ahamal/magic-table/software/esper/firmware/README.md

# Esper firmware (ESP32-S3)

[`firmware.ino`](firmware.ino) runs Esper on the Freenove ESP32-S3-WROOM CAM: Wi-Fi API, both wheels, the flipper servo straight from the ESP32's PWM, the OLED face (bitmaps and animations), the camera and the control page at `http://esper.local/`. Endpoints and how to get pictures: [`../README.md`](../README.md#api). Pins: [`hardware/esper`](../../../hardware/esper/README.md#pins-freenove-esp32-s3-wroom-cam).

## Build

Copy `secrets.example.h` to `secrets.h` (git-ignored) and fill in the Wi-Fi name and password. The ESP32 needs a 2.4 GHz network.

```bash
arduino-cli lib install AccelStepper "Adafruit SSD1306" "Adafruit GFX Library"
arduino-cli compile --fqbn esp32:esp32:esp32s3:PSRAM=opi,FlashSize=8M,PartitionScheme=default_8MB software/esper/firmware
arduino-cli upload --fqbn esp32:esp32:esp32s3:PSRAM=opi,FlashSize=8M,PartitionScheme=default_8MB -p /dev/cu.usbmodem5C930529801 software/esper/firmware
```

Use the USB-C port marked for serial (the CH343, `/dev/cu.usbmodem…`). The camera and PSRAM need `PSRAM=opi`; without it the camera fails to start.

Serial (115200) prints the IP and `READY oled=… cam=…` once it's up.

## How it's put together

- **Cores:** `loop()` on core 1 only runs the steppers. The API server, I2C and OLED run in `netTask` on core 0; the video stream is a second server (port 81) with its own task.
- **Camera:** tries hardware JPEG first (OV2640/OV3660); the bundled GC0308 can't, so it falls back to RGB565 at 640×480 and encodes with `frame2jpg`.
- **Camera sleeps between pictures.** On this board a running camera wrecks Wi-Fi (pings 100–300 ms, multi-second stalls even at 10 MHz). The camera clock (LEDC timer 3) is paused unless a capture or stream is in progress, and a snapshot is sent after the camera goes back to sleep. Measured: idle ping ~11 ms, snapshot ~0.9 s, stream ~2 fps.
- **Battery hardening:** on the power bank the MG996R's current sagged the 5V and tripped the brownout reset. The firmware turns that reset off with `esp_brownout_disable()` (writing 0 to `RTC_CNTL_BROWN_OUT_REG`, the usual ESP32 trick, boot-loops the S3) and lowers Wi-Fi transmit power to 8.5 dBm. `/status` reports `reset_reason` and `boots` (restarts since power-up), so a returning problem shows up at once.
- **IPv6 is on** only so `esper.local` resolves at once on a Mac; without it every lookup waits 5 s for an IPv6 answer.
- **Flipper memory:** the angle is saved with `Preferences` (NVS key `esper/servo`) once the flipper has settled for 2 s with the wheels idle, and only when it changed. At boot `restoreServo()` starts the pulse at the saved angle, then sweeps to `SERVO_PARK` (20°) at 40°/s; `updateServo()` also runs in the Wi-Fi connect loop, so the sweep is done by the time Esper is online. This is the only flash write while running; it waits for the motors to be still because the brownout reset is off.
- **Servo:** LEDC channel 0 at 50 Hz, 14-bit, attached after the camera so it takes timer 0 and stays off the camera's timer 3.
- **Orientation:** the camera is mounted upside down, so it starts with `vflip` and `hmirror` on (180°). The GC0308 driver ignores `vflip`, so for raw sensors both flips are done in software on the frame before encoding (a 180° turn is just reversing the pixel buffer); JPEG sensors flip in hardware. The OLED uses rotation 0.
- **Screen frames** live in PSRAM: two 64-frame buffers, swapped when an upload completes, so a half-received upload never shows. `updateOled()` in `netTask` advances one frame every `1000 / fps` ms and wraps to the first, counting loops; after `X-Repeat` loops (if not 0) it stops on the last frame and sets `done`; a single frame is drawn once, and the status screen redraws every 500 ms. Sending a frame to the OLED over I2C takes ~25 ms, which is why 30 fps is the cap. The frame rate and repeat count are headers (`X-FPS`, `X-Repeat`) because `WebServer` doesn't parse query args when it hands over a raw body.

The earlier Arduino Nano firmware (USB serial protocol) was removed; it's in git history if ever needed. The classic-DevKit bench test is in [`../tests/web_i2c/`](../tests/web_i2c/).
