ahamal/magic-table/software/esper/server/README.md

# Esper server (retired)

Esper used to be a Raspberry Pi 3 running a Python web server that talked to an Arduino over USB serial. Esper now runs on an ESP32, which serves the API itself over Wi-Fi — see [`../firmware`](../firmware) and the API spec in [`../README.md`](../README.md).

Nothing was written here before the switch. The Pi 3 is a spare.
