ahamal/magic-table/docs/log.md

# Build log

What happened, when, and what we learned. Newest at the bottom. Times are ET and approximate unless they come from a commit. Settled choices also go in [`decisions.md`](decisions.md).

## Oct 26 (day 1)

- **12:00** Project structure and design docs (commit `2db1535`).

## Oct 28 (day 3)

- **04:12** Esper switches from Pi 3B + Nano to an **ESP32**. First wheels added (commit `dfce644`).
- **06:01** Printed plywood corner joints for the Esper chassis (commit `ed77900`).
- **Wheels:** the 28BYJ-48 bore was too tight at +0.2 and +0.4 mm. The fit test picked **+0.5 mm** (5.5 mm round, 3.5 mm across the flats).
- **ESP32 bring-up, three rounds, all passed** on a classic ESP32 DevKit:
  1. I2C: VL6180X (0x29), SSD1306 OLED (0x3C), PCA9685 (0x40).
  2. Web server at `esper.local`, about 25 ms per request with Wi-Fi power saving off.
  3. Both 28BYJ-48 steppers over Wi-Fi.
- **The OLED is mounted upside down,** so the firmware sets rotation 2.
- **A 3.3V-to-GND short in the I2C/hub wiring** caused brownouts and failed uploads, and damaged one board. That board still runs, but browns out with Wi-Fi on. Lessons:
  - Meter 3.3V ↔ GND before connecting a board.
  - Upload with only USB connected.
  - `arduino-cli upload` doesn't compile, so compile first.
  - A failed upload erases the flash (`invalid header: 0xffffffff`).
- **11:14** ESP32 bring-up test committed (commit `97774d6`).
- **11:15** Nano firmware removed (commit `42c9ae4`).
- **Speed:** the 28BYJ-48 tops out at about 3.7 cm/s with a 60 mm wheel; 10–20 cm/s would feel natural. Wheel enlarged to **70 mm** (about 4.3 cm/s).
- **NEMA 17 + TMC2208 at 5V: the motor never moved,** with two drivers and a healthy ESP32. These driver boards need **at least 5.5V (12V on some boards)** on the motor supply.
  - Bench Vref was set to 0.77 V.
  - The ESP32 code was step/dir on GPIO 16/17, enable on 18.

## Oct 29 (day 4)

- **Middle-ground drivetrain for Esper:** a NEMA 14 or pancake NEMA 17 on **DRV8834** drivers (2.5–10.8V) would run from the 5V battery. Not bought yet; the 28BYJ-48 stays as the fallback.
- **Servos without the PCA9685:** the ESP32's hardware PWM can drive them directly (GPIO 25, 13, 14), with servo power from the battery, not the 3V3 pin. Not changed yet.
- **Suction gripper:** the 12 mm cup arrived. **The peristaltic pump is too weak/slow** for it. New plan:
  - **Pump:** a 12V self-priming diaphragm pump (uxcell or CrocSee, 1.3 L/min), with the cup on the inlet.
  - **Release valve:** a diaphragm pump **can't reverse**, because its check valves set the direction. A normally-closed solenoid valve on a T vents the line to drop the coin. Desktop arms (uArm, Dobot) and vending pickers release the same way.
  - **Valve choice:** the **AIRZOE 2V025-08**, 12V, outlet wire. It's direct-acting, so it works on vacuum. The 4V210 is pilot-operated and won't.
  - **Sequence:** pump on to grip and hold; pump off and the valve on for ~0.3 s to drop.
  - **Switching:** a **Nano** over USB from the Pi, so a 12V mistake can't reach the Pi 5. Two **30N06L logic-level MOSFET** modules (D2 pump, D3 valve), with a 1N4007 across each load. No H-bridge.
- **Frame bring-up** (separate session):
  - The controller is an **Uno + CNC Shield running GRBL** (not RAMPS + Mega), on the Pi at `/dev/ttyACM0`.
  - The Pi is `ash@raspberrypi.local`.
  - X and Z moves confirmed. A reversed CoreXY motor would be fixed with `$3`.
  - The shared enable pin makes the idle motors click at the start and end of a move. That's normal.

## Oct 30 (day 5)

- **~05:00** The Pi 5 LED was solid red, meaning powered but halted. It booted again after reconnecting.
- **Frame motion test:** a script on the Pi moved ±50 mm 10 times. It ran on X, then Z, then X, Y and Z together. All returned to 0,0,0.
  - The script is `/home/ash/shuttle.py` on the Pi. It keeps the serial port open, because reopening it resets the Uno.
- **Frame tuning at 12V:**
  - **Acceleration:** `$120`–`$122` raised from 80 to **500 mm/s²**. The test went from about 52 s to 28 s, clean.
  - **Max speed:** `$110`/`$111` went 7000 → **9000 mm/min (~150 mm/s)**, which ran clean. **12000 skipped steps**, so it went back to 9000. `$112` (Z) stays at 7000.
  - **Why it's capped:** the estimated ceiling at 12V is about 200 mm/s, set by coil inductance and back-EMF. 24V would roughly double it, but would need the 12V pump and valve on a separate supply. Not doing it.
- **GRBL build checked** with `$I`: **GRBL 1.1h (2019-08-30), CoreXY enabled** (`[OPT:VCZ,15,128]`). Variable spindle, homing forces machine zero. So X/Y moves are already mixed for CoreXY by GRBL.
- **Hub server + jog page** (`software/hub/`): FastAPI on the Pi at port 8000, one kept-open GRBL connection, live status over WebSocket. The page builds on an earlier jog page (click a target on the XY table and Z rail) with hold-to-jog, keyboard, live position, zeroing, STOP and a console.
- **Gripper Nano + server** (`software/gripper/`): Nano flashed from the Pi with avrdude (old bootloader, 57600). Separate FastAPI service on port 8001 with pump and valve switches. Both services came back on their own after a power outage.

## Oct 31 (day 6)

- **~17:40 The Uno started dropping off USB on every move** (`serial: device reports readiness to read but returned no data`). Tracked down:
  - Not the Pi's power: no under-voltage, and a proper supply instead of the Mac's USB-C didn't help.
  - **With the Nano unplugged, 5 move cycles ran with 0 drops.** Plugging it back in dropped the Uno at once.
  - **Cause: a ground loop.** The Nano's ground is tied to 12V − (the MOSFETs need it) and its USB goes to the Pi, so stepper return current found a second path through both USB cables and the Pi. That shifts the Uno's USB ground and resets its USB chip. All the Pi's USB ports share one ground, so changing ports doesn't help.
  - Two Pi "crashes" in between were the Pi 5's power button being bumped (`Power key pressed short` in the log).
- **Fix: GRBL drives the gripper, no Nano.** MOSFET gates moved to the CNC Shield: pump on **CoolEn** (`M8`/`M9`, checked at 5V with a meter), valve on **SpnDir** (`M4 S0` opens, `M3 S0` closes). SpnEn can't be used: in this variable-spindle build it's the Z limit input. No reflash. 5 move cycles with grip and drop each cycle: **0 errors, 0 USB drops.**
- **Hub on port 8000 now runs the gripper** (`/api/gripper/...`, Pump/Valve/Grip/Drop on the jog page). The port-8001 gripper service is disabled.
- **Overhead camera works on the Pi 5** (Camera v2, imx219, now on the Pi 5's own port). `GET /api/capture` returns a 1640×1232 JPEG in about 0.04 s, from a camera kept open by the hub. Still needs a mount ~55–60 cm above the table, centered, looking straight down.
- **Still open:**
  - Steps/mm (`$100`–`$102` = 50) hasn't been measured.
  - GRBL starts in alarm and needs `$H` or `$X`.
  - Camera mount and pixel → gantry calibration.
- **Esper moves to the Freenove ESP32-S3-WROOM CAM** (ESP32-S3 rev v0.2, 8 MB flash, 8 MB PSRAM, CH343 USB at `/dev/cu.usbmodem5C930529801`, MAC `44:b1:76:c7:cd:74`). At first macOS didn't see it at all; a replug fixed it.
- **Dropped from Esper:** the VL6180X edge sensor and the PCA9685. Servos run from the S3's PWM on GPIO 38–40; the OLED is the only I2C device. Pins were then regrouped so each wheel is one 4-pin row on the right header: wheel 1 on 1, 2, 42, 41, wheel 2 on 45, 48, 47, 21, OLED on 20/19 (pin order from Freenove's ESP32-S3-WROOM-1 diagram). The RGB LED on 48 is lost as a mood light. Nothing on Esper stops it at the table edge now; that's the hub's job.
- **The bundled camera is a GC0308** (640×480), not an OV2640. It has no JPEG encoder, so the firmware encodes in software (~370 ms per frame).
- **The running camera wrecked the Wi-Fi:** pings went from ~5 ms to 170–300 ms and a 25 KB snapshot took 1–17 s. Camera off: normal. A 10 MHz clock helped only partly. Fix: the camera clock runs only during a capture or stream. Result: idle ping ~11 ms, snapshot ~0.9 s, MJPEG stream ~2 fps, `/status` still ~20–40 ms while streaming.
- **New firmware** `software/esper/firmware/`: API, wheels, servos, OLED, `GET /capture` (JPEG), `:81/stream` (MJPEG), `POST /camera` (flip). Wheels, servo and capture tested over Wi-Fi with nothing wired yet.
- **Orientation:** camera and OLED are mounted upside down. The camera now starts rotated 180°; the OLED uses rotation 0. The GC0308 driver silently ignores vflip (only hmirror works), so the firmware flips raw frames itself before encoding.
- **No pan or tilt servos;** the flipper is the only servo (GPIO 40). 38 and 39 are free.
- **The OLED shows bitmaps now:** `POST /screen` takes 1024-byte frames (128×64, 1 bit per pixel), up to 64 at once, looped at `X-FPS`. Without a picture it shows a status screen ("not connected" or the IP). The control page has a drawable screen preview and a text box that renders into it; a drawn frame reaches Esper in ~50 ms. The OLED was found on the S3 at 0x3C on the new pins.
- **Gotcha:** the ESP32 `WebServer` doesn't parse query args when it hands over a raw body, so the frame rate is a header (`X-FPS`), not `?fps=`.
- **Control page driving:** an arrow pad (and keyboard arrows) plus an accel box. On the bench, both wheels + turns Esper anticlockwise, so the wheels face opposite ways: ← = +/+, → = −/−, ↑ forward = s1 −, s2 + (checked on the bench). Speed and accel are sliders.
- **Battery resets:** on the power bank Esper dropped off Wi-Fi when the servo moved. The servo is an **MG996R** (not an MG90S): up to ~2.5 A stalled, against the bank's 5V/3A USB-A port. Capacitors (2× 470 µF) and a 1N5819 diode in the ESP32's 5V feed didn't help. A restart-reason readout showed **brownouts**, not the bank cutting out. Fix in firmware: brownout reset off (`esp_brownout_disable()`; the raw register write boot-loops the S3) and Wi-Fi transmit power at 8.5 dBm. After that it stayed up on the bank through servo and wheel moves. Still a risk: a servo held stalled against its end stop, or a low bank.
- **Faces:** `software/esper/faces/` holds ready-made screen animations, drawn in code by `make.py`: blinking, glancing **eyes** (56 frames, 12 fps) a pecking **chicken** (4 frames, 3 fps), and a **portrait**: a cartoon of the person on Esper's camera, smiling, blinking and waving (20 frames, 6 fps). A dithered photo didn't work: the person was backlit by a window and came out as a dark blob at 128×64, so a drawn cartoon reads far better. All played on Esper.
- **API tidy-up:** the full Esper API reference is in `software/esper/README.md` (every endpoint, field, error and a typical agent loop). `/info` keys are now `max_steps`, `max_speed`, `max_accel`. `/screen` takes `X-Repeat` (0 = forever, N = play N times then hold the last frame), and `/status` reports `screen.done`. Tested: play-once finished in ~1 s, play-3× in ~3 s.
- **Faces on the control page:** a grid of 19 animations drawn in the browser (eyes, chicken, happy, wink, love, sleepy, surprised, angry, dizzy, talking, heartbeat, bounce, rain, stars, code, spinner, fireworks, countdown, marquee), with a page preview and a loop/once switch. Tested on Esper: sent in ~130 ms, play-once ends with `done: true`.
- **Servo speed:** `/servo` takes an optional `speed` (1–600 °/s); Esper sweeps the flipper there in 10 ms steps, and `/status` shows `servo_now` and `servo_moving`. No speed = jump, as before. Tested: 90°→120° at 30°/s arrived in ~1 s. The page has a flipper speed slider.
- **Flipper resting pose:** 20°. Esper saves the flipper angle to flash once it has settled (2 s, wheels stopped). At boot it starts at the saved angle (no jump) and sweeps to 20° at 40°/s while Wi-Fi connects. Tested: moved to 60°, restarted, it came back at 60° and parked at 20°.

## Nov 1 (day 7)

- **Two cameras on the Pi 5:** cam 0 = ov5647 (5 MP), cam 1 = imx219 (Camera v2). The second only showed up after reseating its ribbon with the Pi off; the Pi detects cameras at boot only.
- **Hub serves both:** `/api/capture?cam=N`, `/api/stream?cam=N`, `/api/cameras`, and live views of both on the jog page.
- **An open stream stalled hub restarts** (uvicorn waits for it). `hub.service` now has `TimeoutStopSec=4`.
- **Speaker:** the Pi is paired with an Anker SoundCore 2 over Bluetooth (default output, 40%). Its mic only works in the low-quality headset profile, so voice input comes from phones instead.
- **Talk page** (`https://raspberrypi.local:8443/talk`): phones record an utterance, the hub sends it to Meta's Muse Voice Transcribe (one-shot `/v1/asr/transcribe`) and every page shows the text. A test sentence came back right in 1.3 s. The hub now runs HTTP :8000 and HTTPS :8443 (self-signed; browsers only allow the mic on HTTPS) from one process (`serve.py`). The API key lives in `~/hub/.env` on the Pi only.
- **X/Y steps/mm measured: 40** (was a guessed 50). A 100 mm jog now moves exactly 100 mm. Two rough measurements first disagreed (118 and 105 mm) because of a loose nut. 40 matches a GT2 belt on a 20T pulley with TMC2208s at 1/8 step. Max speed `$110`/`$111` raised to 11000 real mm/min, about the step rate that ran clean on Oct 30.
- **Black game board** (711 × 558 mm, black paper) with the four corner markers: cam 1 finds all four. Markers re-sized smaller (30 mm corners, 25 mm head, 30 mm Esper) after a test showed the far ones still detect when simulated at 15 mm.
- **Vision, no cloud AI** (`software/hub/vision.py`, `/api/scene`, 3D page at `/scene`): OpenCV on the Pi, calibrated against the gantry with the head marker. First run (cam 1): head check 0.7 mm, Esper's height read as 106 mm (it's 107).
- **Calibration accident:** with Z already at its top, calibration went "up 40" (stalled, steps lost but counted), then "returned" by count, 40 mm too low, and tore the board paper. A reset didn't stop the calibration thread either (it kept sending moves; only restarting the hub did). Fixes: Z inverted with `$3=4` so Z+ is up; calibration starts at the top and only goes down, to 15 mm above the board, from a `room` you give it; any reset, pause, alarm, error or STOP aborts it with no further moves; it returns by going up first.
- **Z measured: 40 steps/mm** (100 commanded moved 126 at the guessed 50). Work coordinates now: **0, 0, 0 = board center with the cup touching it**, Z+ up, top ~150, travel height 120.
- **Calibrated** with the grid shifted away from Esper (Esper can only be ~15 cm from the center): ±50 mm around (25, 50), at Z 120, 67.5 and 15. Cam 1: 24/27 stops, 1.07 px; cam 0: 18/27, 0.79 px. Board height from a touch at 0, 0. Checks: board markers 1 and 2 came out 470 × 427 mm apart (tape measure: 470 × 430); a card was found as 62 × 84 mm (63 × 88); head check 2.1 mm at Z 120.
- **First pick:** a card at (55, 40) picked and dropped at 0, 0. Then a centering test showed the cup ~25 mm off the card center: the cup sits in front of the Z extrusion (18 mm from its center, by ruler), not under the marker. Fixed with a cup offset (24.7 mm from the marker plate's center, by camera) and `/api/tip`; next test landed within ~2–3 mm of a card center.
- **Esper re-measured:** 130 × 130 × 100 plywood box, 3 mm off the ground on its wheels, corner caps 2 mm proud (105 to the top). Travel height lowered to 110. Rule relaxed to what matters: nudging Esper sideways is fine, pressing down into it isn't, so jogs may go sideways anywhere and only lowering onto Esper is refused.
- **Table guide** (`software/hub/GUIDE.md`, served at `/guide` and as plain text for agents at `/api/guide`): coordinates, limits, gripper, pick-and-place recipes. Recipes like "a card needs 3 s of pumping" live there, not in code: `grip` keeps the pump on, `grip?pump_s=N` pumps N s and then holds on the vacuum (~20 s).
- **agent/ folder:** one place for agents to start: [agent/README.md](../agent/README.md) (what's available, how to behave, ask the humans), [table.md](../agent/table.md) (moved from the hub's GUIDE.md), [esper.md](../agent/esper.md). Served at `/api/guide`, `/api/guide/{table,esper}`, `/guide`.
- **Voice:** `POST /api/say` speaks on the SoundCore 2 (espeak-ng; the hub service now has the user's audio session, linger on).
- **Esper driven and calibrated with the overhead camera:** forward 0.048 mm/half-step, turning 0.0351 deg/half-step left and 0.0373 right, ~30 mm/s at speed 800. Flipper checked: it sweeps in the plane of Esper's front face (20 rest, 60 sideways, 110 over the top); drawn in 3D at its live angle (the hub polls Esper's `/status`).
- **Esper home:** the middle of the left margin, in line with the left board markers, facing into the board. The hub drives Esper there (or anywhere) with the camera checking: `/api/esper/goto`, `/api/esper/home`. First trip: one move, 16 s, 0.4 mm off. Drawn in 3D as a green outline.
- **Cards turned with Esper and stacked:** six cards, each put on Esper's top, turned by Esper to the target angle (90.5°) and stacked: ~35 s a card. Learned: square Esper to the card first (at 45° it lands tilted on a corner cap and the pick fails), then find the card on Esper with cam 1 (it drifts 5–15 mm) and pick it with a 2 s pump. Esper's turning centre is ~9 mm in front of its marker.
- **Hub restarts no longer reset the Uno** (`stty -hupcl` before the hub opens the port), so deploying doesn't cost a re-anchor.
- **Home page** at `/` lists every page (jog moved to `/jog`), with a live status line.
- **Cam 1 drifted 57 px**; recalibrated (cup within ~1-2 mm of a card centre after). Calibration sped up to ~41 s (rapid moves within a level, 0.25 s settle) and keeps the board touch-off and bounds.
- **3D:** marker plate flush on the extrusion face; Esper's wheels 5 mm forward; the flipper moved to the right side by the wheel (it isn't on the front face).
- **3D fixes:** the head's extrusion now stands behind the marker plate (it was drawn through it), camera modules 2.5x so they're visible.
- **Board bounds:** the cup now stays inside the rectangle between the board markers' inner edges (X ±216, Y ±195), measured from the markers (`/api/calibration/bounds`); X/Y 0, 0 moved to its centre (a pure shift of GRBL's work coordinates and the camera models, no recalibration).
- **3D page:** camera modules drawn where calibration puts them (cam 1 ~39 cm up at the front-left, cam 0 lower at the front-left corner), with each picture's footprint on the board; the cup bounds as a dashed line; the cup is 15 mm across (sold as 12 mm).
- **Camera-bump correction turned off:** with markers that had moved since calibration it warped the scene (marker 1 at 667, 600). It only warns now.
- **All six cards in one stack.** A faster run (1 s pump plus an F2000 peel-off) silently left three cards behind; one change at a time showed the peel speed was the problem. Working recipe: approach F1200, 1 s pump, peel F1500, lift to Z 40, place F1200: ~7.5 s per card. In the guide.
- **Build notes for agents** (`GET/POST /api/notes`, kept on the Pi in `~/hub/notes.md`, not in git): what was learned about this particular table. Seeded with today's numbers; the guide says to read them after the guide.
- **Stacking:** two card pairs stacked by picking and placing card centers. The second (2♣ on a card 1° apart, 12 s from grip to drop) came out with the bottom card barely visible.
- **Re-anchor fix:** after a restart the camera put the head 33 mm off at Z 120 far from the calibration grid, and re-anchor trusted it. Now it restores the saved position by default (exact when nothing moved) and only uses the camera when asked.
- **Z limits in the hub:** −1 (a 1 mm squeeze for gripping) to 150 (top of travel). Moves outside are refused, Z jogs are cut short at them.
- **3D page:** head built from the measured offsets (cup 18 mm in front of the extrusion), Esper with wheels and proud caps, and a 2 mm / 3° deadband so detection noise doesn't make the view shimmer.
- **Esper rule:** the start height is the travel height; below it the hub won't move the head over Esper (moves go up first, jogs are refused).
- **Camera placement:** a true overhead camera would sit behind the gantry. Plan: a camera on the head looking down for precise picks (pick-and-place style), a fixed angled camera with ArUco table markers for finding things, SAM 3.1 to find cards.

## Nov 2 (day 8)

- **Card flipping with Esper's flipper works.** The crane drops a face-down card in front of Esper's face, its near edge on the lowered flipper; Esper lifts the flipper to 65° and rolls ~95 mm forward at the same time; the card stands up and tips over, flat, ~10 cm further on. ~4 s plus the place. 14 flips, all flat, both ways over (one more failed because the flipper had been left up: lower it before placing).
- **The card turns 3–5° clockwise per flip.** Moving the card along the blade changed it a little (23 mm right of centre ~7°, 15 mm ~3.6°); curving Esper during the push (3.6° and 9.6°) didn't help. A new, straight flipper hand (level and centred at 65°) still turns it 3–5°. Fine for dealing (each card flips once); re-square a card that's flipped again and again.
- **Speeds:** full speed (servo or wheels) drops Esper's Wi-Fi ~5% of the time; ~80% is fine. The hub's Esper goto now drives at 640.
- **Missed reset:** the Pi rebooted and the Uno with it, before the hub was listening, so no banner was seen and the hub didn't ask for a re-anchor (the head happened to be at the saved spot). Now GRBL found in alarm on connecting counts as a reset, and `/api/move`, `/api/tip`, `/api/jog` and `/api/esper/goto` refuse until re-anchored (they used to skip the limit checks instead).
- **Picks:** a card that had just been flipped face-up didn't come up at Z −0.8 (twice); Z −2 with a 2 s pump did, and Z −1.5 worked for the flips after. In the table guide.
- **3D page:** the flipper redrawn: servo 42 mm from the right axle at 45°, the arm swings beside the box, the bent part runs across the whole face; on the table at 20°, level at 65°.
- **Snapshots:** multi-step jobs save both camera photos at each stage, for reviewing a failure later (in the agent guide).
- **Speeds settled:** Esper's wheels at full speed and acceleration (800, 1000), the hub's goto too; the flipper at most ~60% of its max (`speed` ≤ 360), always with a speed.
- **One port:** HTTP and HTTPS both on :8000 (the first byte of a connection says which; the two servers behind it listen on the Pi only). :8443 is gone; the talk page is `https://raspberrypi.local:8000/talk`.
- **New voice:** Piper (local neural TTS) replaces espeak-ng behind `/api/say`, streamed a sentence at a time so a line starts at once; ~1.5 s to make 5 s of speech on the Pi 5. `GET/POST /api/voice` picks the voice and pace. Meta's Model API has speech-to-text (Muse Voice) but no text-to-speech.
- **The House:** only the crane speaks (the speaker is the Pi's), as the dealer; Esper stays silent and expressive. Sampled 14 Piper voices on the speaker and Meta's MMS-TTS (6.5 s to make 3 s of speech, one English voice); tried Piper Semaine "Prudence", then chose a male voice, Norman, at pace 0.85. `/api/voice` takes a `speaker` for multi-speaker voice files.
- **Talk page is a chat:** what people say or type and every House line in one log (`chat.jsonl`). Agents follow it with `GET /api/chat?after=<id>&wait=30` (waits for something new; tested: answered ~2 s after a message was posted) and answer with `/api/say`. Typed messages via `POST /api/chat`.
- **Live transcription:** the talk page streams the mic through the hub to Muse Voice's realtime endpoint (`wss://api.meta.ai/v1/asr/realtime`: a JSON handshake with the key, 16 kHz PCM16 frames, `endStream`; `transcript` messages with `final`). Words show about 0.3 s behind the speech, on every open page; the final text ~0.1 s after the end. Keyword biasing works there too: "I'll call" came out as "alcohol" without it, right with it.
- **Who's who:** no persona names. The agent speaks as itself (`/api/say` takes `by`, its name), the crane is its hand, and Esper is a character it puppeteers. "The House" is gone from the code, guides and talk page.
- **Esper's gestures:** 29 gestures (yes, no, thumbs up/down, shrug, celebrate, sulk, smug, peek, fold, all in…) in `agent/gestures.json`, played by `POST /api/esper/gesture {name, to?}`: one of 24 new reaction faces plus flipper and wheel moves that end where they started. Each goes in the chat as Esper's, shown on the talk page as a stage direction ("Esper 👍 thumbs up at Sam"). Esper makes no sound.
- **Eyes: SAM 3.1 via Meta's Model API.** `GET /api/look?what=playing card` sends a fresh cam 1 picture to `sam-3.1` (Responses API, streamed; Meta's `meta_sam_parser` decodes the masks) and maps each mask onto the board: ~3.4 s for a full 1640×1232 picture. The cards came out within ~1 mm of the classic detector at 62×87 mm (true 63×88), plus a 2♣ half under Esper's cable that the classic detector missed. False matches beyond the board (a marker, something by the frame) are flagged `on_board: false`. No confidence scores in the output. "face down playing card" still matched all four (face up too). The `/eyes` page shows each look live.
- **SAM finds, Muse Spark answers.** SAM can't tell which card (“king of spades” found nothing, “two of hearts” found the heart pips, “face card” every card), so `/api/look` takes `ask`: a question Muse Spark answers about each thing SAM found (its crop), or about the whole picture. Read every card right from cam 1 (crops ~150–250 px). Muse Spark's thinking was the slow part (2,100 reasoning tokens and 15 s for the K♠); `reasoning: minimal` gave the same answers in 0.5–2 s a crop and 3 s for the whole picture, so it's the default. Kept generic: the question is the caller's (which card, what colour, what is it).
- **Eyes v2: see, find, check.** `/api/see` (Muse Spark names what's on the board, ~2 s) and `/api/find` (SAM 3.1 in both cameras: footprint, height, pick point, ~3 s) replace `/api/look`. Heights by carving (points both cameras see as the thing): the AirPods case came out 21.0 mm (true 21). The first try was 12.5-24.5 mm, because the cameras had been calibrated over a 100 mm patch only; recalibrated over a 5x5 grid ±130 mm at cup Z 110/75/40 (2 min; cam 1 1.7 px, cam 0 2.9 px). The pick point was 20 mm off at first: cam 1 looks at 48 degrees, so the middle of what it sees is partway down a thing's near side, not its top; the footprint centre is right. SAM found the case from above only as "white object", so `see` gives a backup name with each thing and `find` tries names in turn. Picked and put back the case 3 times (press 5 mm below the top; 1.5 mm only touched it). `/api/find/check` tells whether a pick took from cam 0's view of the spot (0.77 changed when lifted, 0.03 when not). The 3D scene's "Scan items" button runs see + find and shows each thing as a fading ghost with its pick ring; its Calibrate button now covers the whole board. The /eyes page was rebuilt in the jog style: steps on the left, a log of looks on the right.
- **Vision page** (was /eyes; /eyes redirects): a short query panel on the left (camera, "See what's on the board" filling Find with chips, Find, an optional question, options folded away); on the right every see, find and check (anyone's, broadcast as `vision` events) as one line each, newest first, opening on a click to its parameters, pictures and results. Check is a button on each found item.
- **Find uses one camera, chosen** (cam 1 by default, cam 0, or Esper's): no height any more (two-camera carving is in the log above if it's needed again); check compares the item's outline in the same camera, so it works for Esper's camera too. Cam 0 is too low for footprints (a 55 mm case came out 95 mm long). The vision page has See and Find as separate sections, each with its own camera; See's names are chips that add to Find; the results page left and right instead of scrolling (a page of lines, or one opened action with ‹ › and arrow keys). The 3D scene's panel is shorter (calibration folded away, opening by itself when something needs attention), and "Scan with SAM" has its own box at the top right.
- **Fixed "vision: 'int' object is not subscriptable"** repeating in the GRBL log: the scene loop reused `w` (the head's position) for the picture's width, so whenever a camera saw the head marker it crashed reading the head's Z. It had been there since the board bounds work; the whole-board recalibration made the head visible most of the time, so it fired constantly. The head check works again (cam 1 sees the head ~6 mm from GRBL's position).
- **Vision history on disk:** every see, find and check goes to `~/hub/vision/` on the Pi (`history.jsonl` plus each action's pictures, the last 100 kept), so the /vision page shows the same list after a reload, on another device and after a hub restart (tested: three actions, restart, all three back with their pictures). Before, only the last action lived in memory. `GET /api/vision/history`; pictures by action number.
- **"Zero Z" button** (was "Board is here"): sets GRBL's Z to 0 where the cup touches the board (G10), the fix for a Z that skipped steps (a lift stalled at 10:5x; the camera then saw the head 46 mm from GRBL's position). "Board is here" only moved the cameras' board height to match a wrong Z. After a fresh calibration it also shifts the camera models to the new Z. Calibrate no longer asks how high the cup is: once the board's been touched, Z is that height.
- **Find ignores the robot.** SAM sometimes named the machine (the suction cup as a plate, a wheel as a knife). Now Muse Spark sees SAM's matches numbered on the whole picture and keeps only loose things that fit the first name asked for (a fallback like "white object" must still be the plate). The robot is outlined from where the hub tracks it, as boxes around the cup, the Z extrusion and Esper projected into the picture, at no API cost; a match mostly inside them is dropped unless Muse keeps it (a card on Esper). If Muse can't answer, that rule alone decides. Things near the robot keep their pick point. Tested live: "plate" found the saucer beside the cup, not the cup; a find on a board with no saucer correctly came back empty. A find is ~3.5–5 s now (was ~3). A ChatGPT session had tried this with two extra SAM calls per find for robot silhouettes and no pick point for anything touching them; replaced, since it would have blocked picking cards on Esper.
- **Render poly** (3D scene, after a scan; `/api/find/shapes`): Muse Spark describes each found thing, from its crop turned lengthwise, as 4–12 solids (body plus details: caps, clips, rims, buttons; offsets, heights, rings), and the page builds them on the thing's footprint, low-poly. ~7 s. Good on pens, a phone, a knife; hit and miss on plates and glass. Demo garnish only. Scan ghosts now hold at 50% until the next scan or render instead of fading.
- **The head marker is on thin card on the Z extrusion's left face** (facing −X, toward cam 1, ~1 mm out), not on the printed 4 mm plate. Checked every calculation: they all work from the marker's centre (calibration fits the cameras to it; the cup is the measured `TIP_OFFSET` from it), so none needed changing. The 3D head and find's robot box had assumed the extrusion was behind the cup, which put the marker ~11 mm off; both are now built around the marker.
- **Pages:** "Scene" is "3D Scene"; every page's top bar links Home, Jog, 3D Scene, Vision and Talk (minus itself), Talk included.
- **Calibration ran off the board.** Started from the 3D page with the head near the far edge (Y 205), the ±130 mm grid was centred there and went to Y 335, about 120 mm past the board, at full rapid speed; the head skipped ~118 mm in Y and 39 mm in X. Three gaps lined up: the grid was centred on wherever the head was (fine for the old 60 mm grid, not the whole-board one), calibration sent its moves without the bounds check jogs and moves get, and removing the "how high is the cup?" prompt had also removed the reminder to park it in the middle. Stopped with hold + reset. The camera re-anchor then made it worse: it read one camera at the saved Z (72) while the head was at 15, came out 451 mm off, and wrote Z 72. Recovered by triangulating the head marker from both cameras (1.5 px apart): X 85.9, Y 43.6, Z ~12 vs GRBL's 47, 162, 15; set X/Y from that, head check back to ~5 mm. Fixed: calibration centres on the board, rises to the travel height first, refuses before moving if any stop leaves the bounds or Esper is under the grid, and moves at 3000 mm/min instead of rapid; a "Stop calibrating" button ends it after the current move without a reset; the camera re-anchor triangulates both cameras and keeps GRBL's Z, and the 3D page's Re-anchor offers it when the cameras disagree with the saved position by more than 10 mm.
- **Cup offset, by eye.** After recalibrating (cam 1 had moved 11 px), the cup was 3 mm left and 5 mm short of chip centres, the same at two chips 90 mm apart. The user's ruler: the cup is 20 mm in front of the marker, not 24.7. `TIP_OFFSET` is now (−2.4, −19.7). On the far side the cup still lands ~6 mm toward the front (checked twice), and the X makes no physical sense (the cup is ~11 mm right of the card, in line with the extrusion): see below. The 3D head now draws the gripper bolted to the extrusion's front face, the card on its left face.
- **The board is probably lower than the hub thinks.** Board marker 1, triangulated from both cameras, is 74.8 mm below the head marker's plane at work Z 0; the hub uses 57 (`TIP_BELOW_MARKER`); cam 1's marker-size estimate says 66.6. Esper's top marker agrees with ~75 (Esper 103.5 mm tall, true ~105). If so, cam 1 maps everything onto a plane ~18 mm too high, which explains the odd cup X and the far-side drift. Waiting on a ruler: the head marker's centre down to the cup's bottom edge.
- **Heights from cam 0** (`find?height=true`): cam 0's outline of each thing, matched to cam 1's footprint, and two closed-form solves (a picture row is a plane through the camera): slide the footprint along cam 0's line of sight until its near edge sits on the outline's bottom, then raise its far edge to the outline's top. Cam 1's position error cancels. Simulated: 3.3 → 3.7, 6.6 → 6.6, 21 → 20.3 mm, also with cam 1 6 mm off. On the table it matched nothing: cam 0's board level is 30–40 px off (the board height above), so it's off by default.
- **Stacks from above:** the outline's length minus its width says how many chips (1–2 mm single, 6–8 double; 8 for 8 right). Muse from cam 1 crops can't count stacks. Find needs the head parked: the Z bar hid 2 of 5 chips with the head at the front.
- **Esper looks for the agent.** `/api/esper/look` drives Esper to face a spot from ~120–150 mm; then `find?cam=esper&ask=` with `effort=low` counted a 4-chip stack right (`minimal` said 3, the whole picture from home said ~3). Before any move cam 1 checks Esper's way (`check`, default; ~1 s, no API call): a first version went ahead when it couldn't check and drove through the chips. Esper's home moved to the far margin, facing the players (out of cam 0's view); park the head at the front before sending it home, or the gantry's wires hide its marker. New gestures: `on_it`, `counting`, `woke_up` (a new x x face, for after a brownout: the agent covers for it in character). A flipper move in the first `on_it` browned Esper out, so it only nods now.
- **A first hand, flop to hole cards.** Find read all 9 cards and the deck, the flop right (6♥ 8♠ 10♠), and split an overlapping pair; down to ~12 s with reading once Muse only checks matches near the robot. Cards stayed behind until Z was re-zeroed (it had crept ~1 mm high). Hole cards: holding one over Esper's camera with the cup was too small to read; laying it on Esper's flipper and lifting it ~50° showed its corner (Esper's guide, "Peeking"). An improvised flip (flipper past upright, no drive) stacked two cards crookedly: the written flip (lift and drive together) is the one to use.
- **Esper's position is kept.** When cam 1 can't see Esper (window glare in the far-left corner, the gantry cable lying over it), the hub uses where it last saw it plus its own moves since (`assumed`), saved across restarts. Esper's way check ignores single lying cards (Esper drives over them). Esper's home moved left to (-90, 215).

## Nov 3 (day 9)

- **MCP server by Muse Spark, reviewed** (`software/agent/`): a stdlib MCP server wrapping the hub, a minimal Muse Spark loop and a smoke test. The design held up (hub only, tiered vision, chat polling), with six fixes:
  - **No homing tool:** it ran `$H`, and this build has no limit switches, so the axes would have driven into the frame. Replaced by **`unlock`** (exactly `$X`), which an agent needs after any reset before re-anchoring and had no way to send.
  - **Card picks:** the hub's Z floor was −1 and the recipes pick at −1.5 (−2 for stubborn cards) through raw G-code, which the MCP rightly doesn't expose. Z_MIN is now **−2**, and the guide's recipes use `/api/move {z, feed}` instead of G-code.
  - **Flip and peek through the hub:** new `POST /api/esper/move {servo, servo_speed, turn, drive, wheel_speed}`, the flipper and the wheels at once, servo speed required and capped at 360, counted into Esper's assumed place (Esper's own `/step` isn't). MCP tool `esper_move`.
  - **`chat_post`** defaulted to `by: player`, so the agent's notes would have come back to it as players' words; it now posts under the agent's name and refuses `player`.
  - **Runner:** it sent the model's tool calls back inside an assistant message; the Responses API wants the output items themselves. Fixed and checked against a fake API. STOP no longer waits for the first-motion y/N; the agent's own reasoning effort is a flag (`low` by default).
  - Also: `move_tip` never moves diagonally (up to travel height, across, straight down), and `see`/`find` pass `by`.
