ahamal/magic-table/hardware/frame/markers/markers.pdf

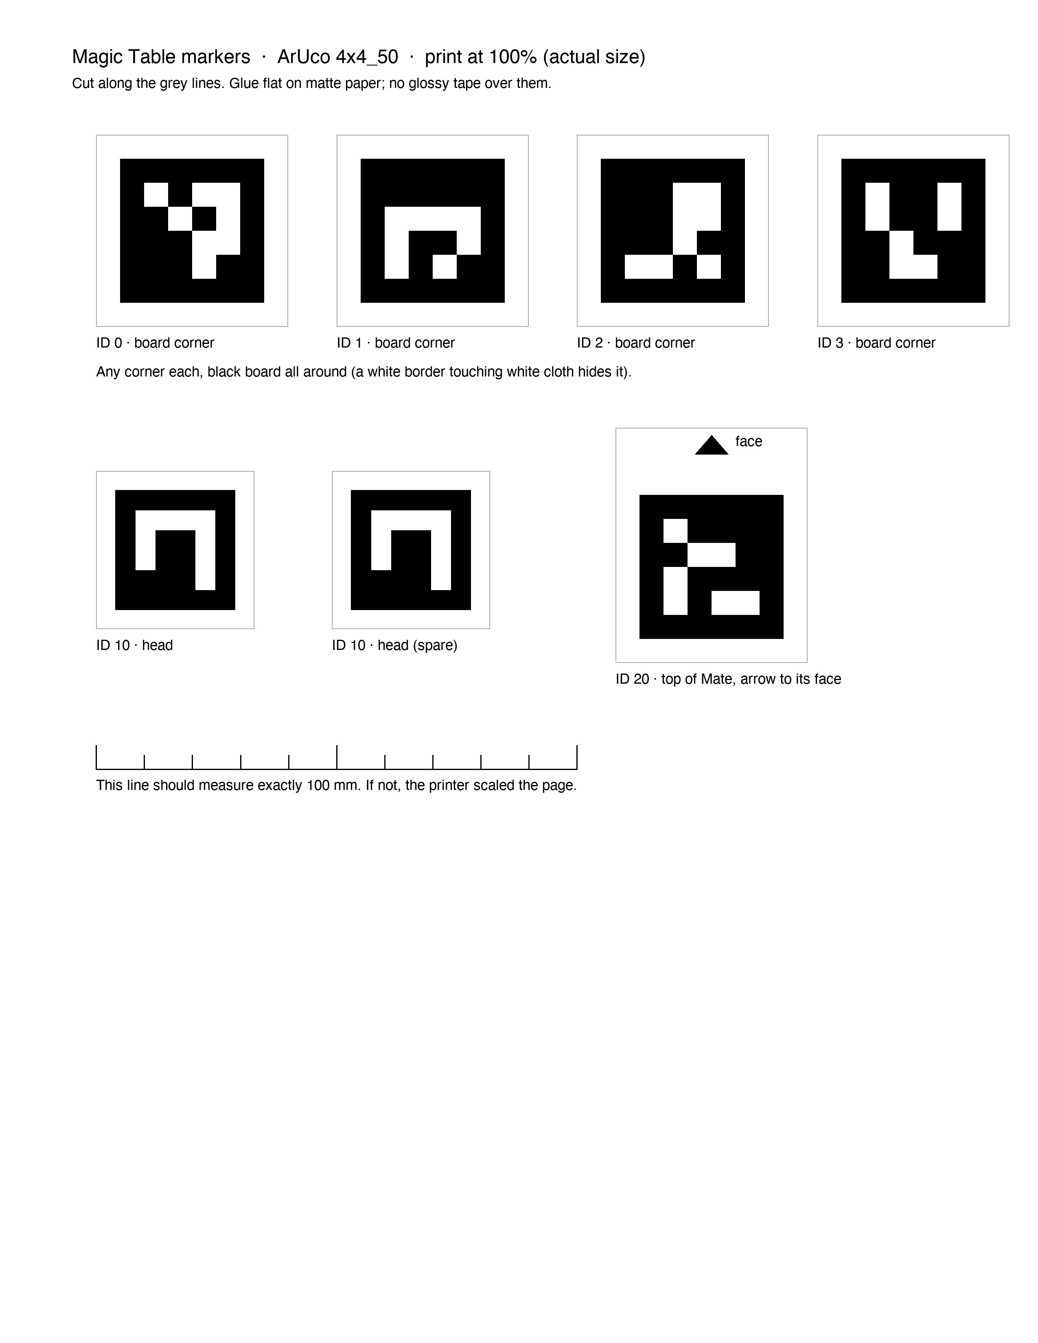
[picture p5: page 1]
