ahamal/magic-table/software/esper/faces/reactions.png

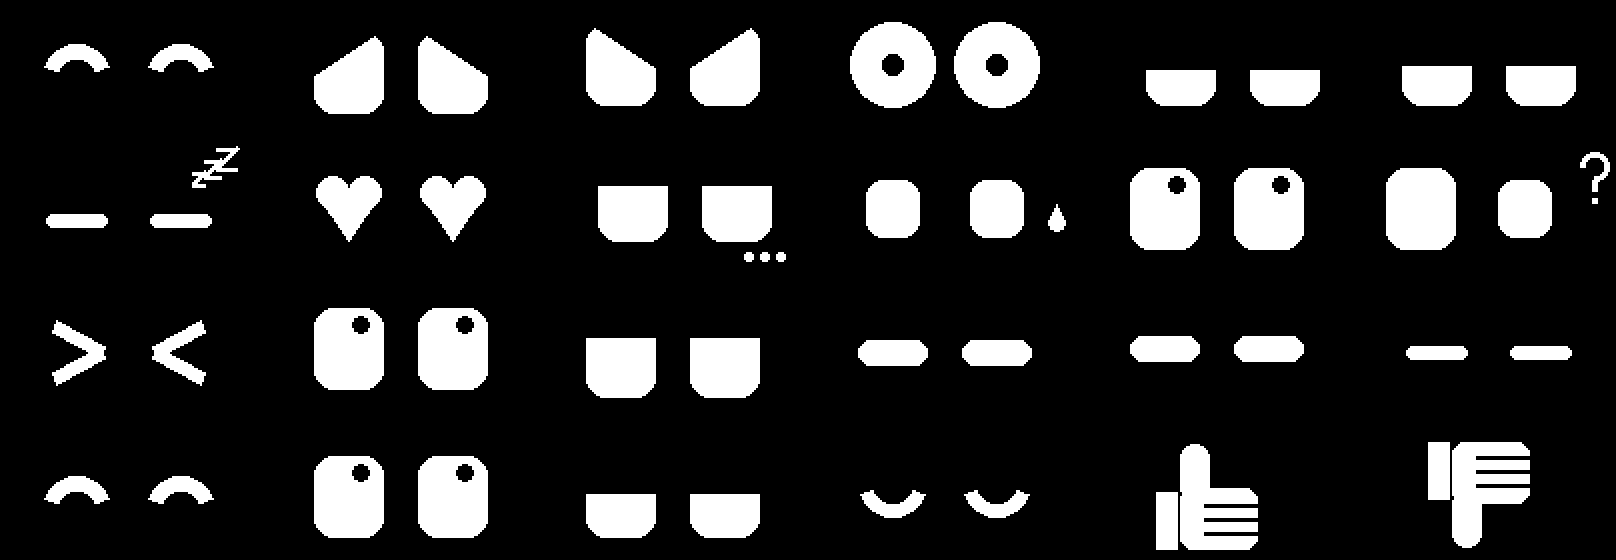
software/esper/faces/reactions.png
