ahamal/magic-table/hardware/esper/chassis/slot-test.stl

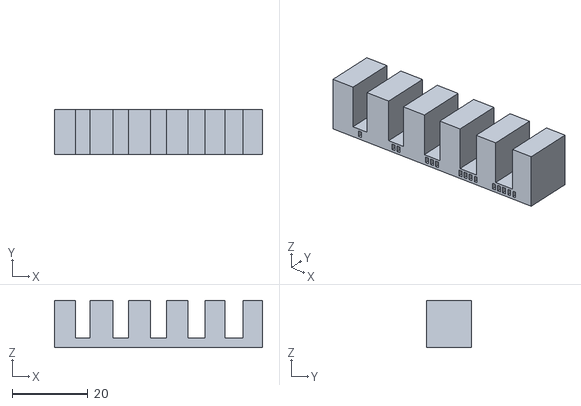
[picture p7: CAD file, 2026-10-28]
hardware/esper/chassis/slot-test.stl
55.0 x 12.0 x 12.5
