ahamal/magic-table/hardware/esper/wheels/wheel-70.stl

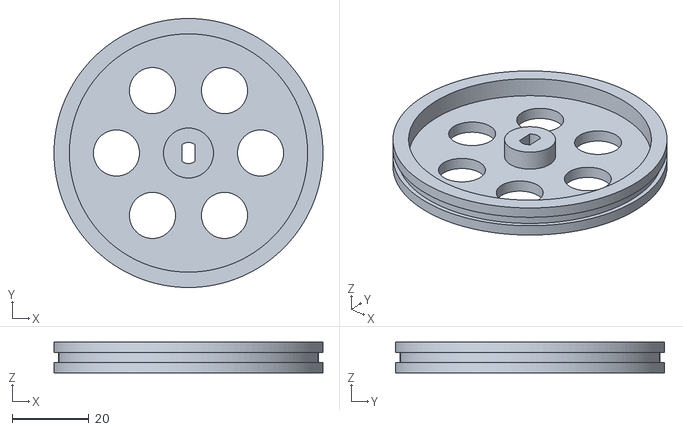
[picture p8: CAD file, 2026-10-30]
hardware/esper/wheels/wheel-70.stl
70.0 x 70.0 x 8.00
