ahamal/magic-table/hardware/frame/markers/marker-mount.stl

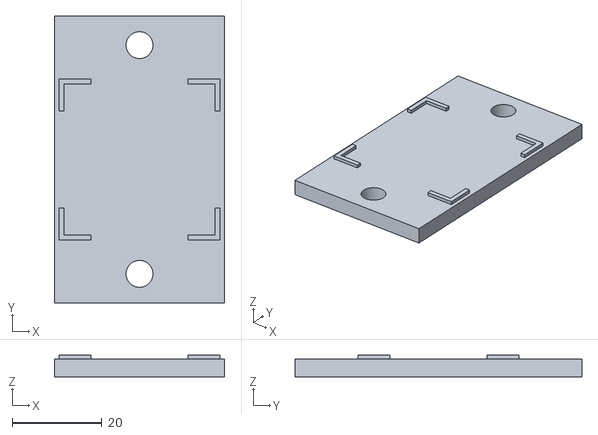
[picture p9: CAD file, 2026-11-01]
hardware/frame/markers/marker-mount.stl
38.0 x 64.0 x 4.80
