ahamal/magic-table/hardware/esper/chassis/corner-normal-v3.stl

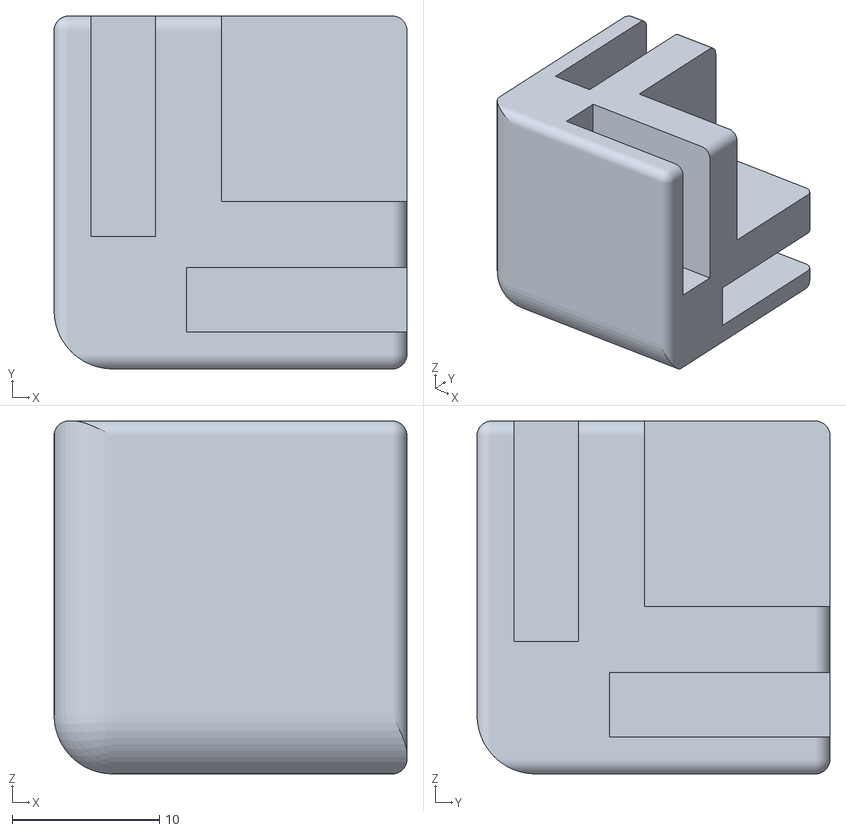
[picture p10: CAD file, 2026-10-28]
hardware/esper/chassis/corner-normal-v3.stl
24.0 x 24.0 x 24.0
