ahamal/magic-table/hardware/esper/wheels/fit-test.stl

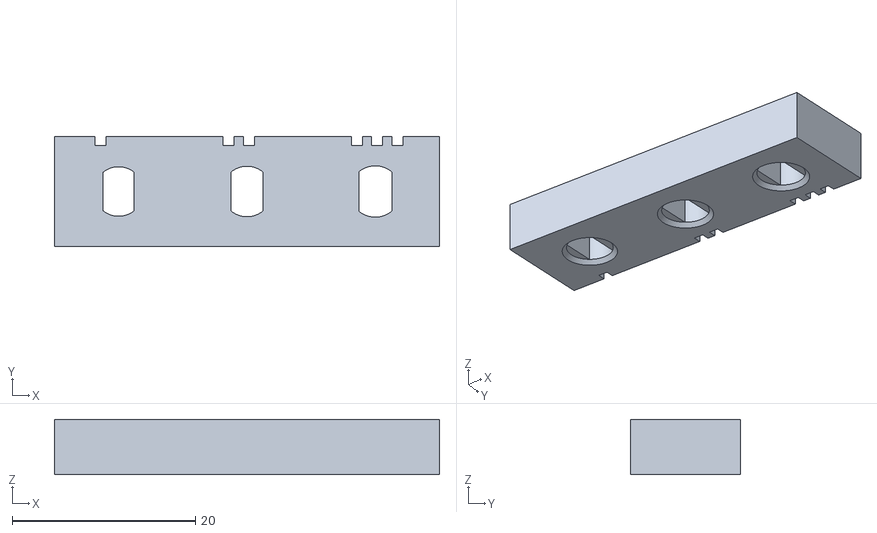
[picture p11: CAD file, 2026-10-28]
hardware/esper/wheels/fit-test.stl
42.0 x 12.0 x 6.00
