ahamal/magic-table/hardware/esper/chassis/corner-thick-v3.stl

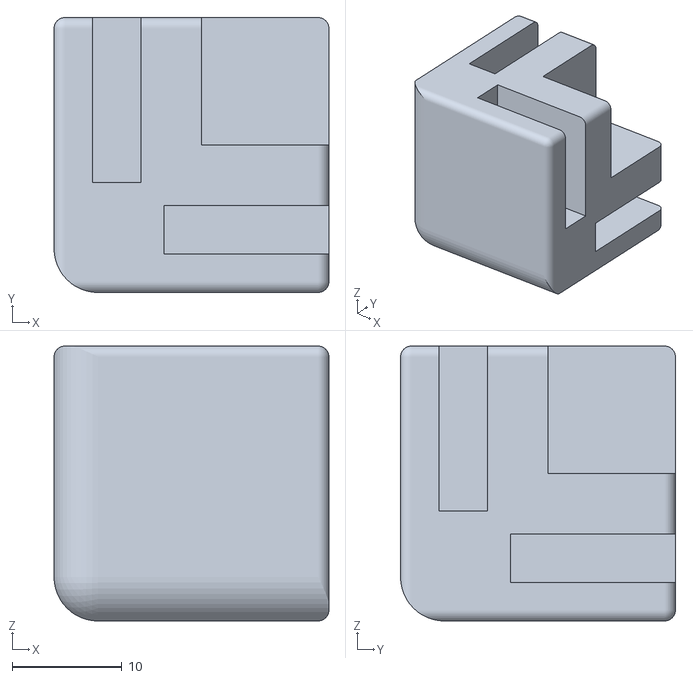
[picture p12: CAD file, 2026-10-28]
hardware/esper/chassis/corner-thick-v3.stl
25.0 x 25.0 x 25.0
