ahamal/magic-table/docs/notes-on-this-build.md

# Notes on this build

> A copy of the notes the agents and I kept on the hub while building (`~/hub/notes.md`, served at `/api/notes`), as of Nov 4, 2026. Agents read them before moving anything; they hold the measured numbers and lessons that the guides in [`agent/`](../agent/README.md) build on. Esper was called "Mate" until Nov 3; the name is updated here. Times are the Pi's clock.

- 2026-11-01 16:39 (claude): Origin: work 0,0,0 = middle of the board with the cup touching it. Z is the cup height above the board. Z steps/mm 40 (X/Y 40 too), $3=4 (Z inverted so Z+ is up).
- 2026-11-01 16:39 (claude): Cup offset: the cup sits ~25 mm in front (-Y) of the head marker plate centre (0.6, -24.7), 18 mm in front of the 2020 extrusion centre. Use /api/tip. Cup lands within ~2-3 mm of a card centre.
- 2026-11-01 16:39 (claude): Cards: pick at Z -0.8 (single card on the board; +0.3 per card underneath). Place at 1.2 mm above the surface (+0.3 per card in the stack). Approach F1200 from Z 3 is fine.
- 2026-11-01 16:39 (claude): Gripper on cards: grip?pump_s=1 is enough. Peel-off at F1500 works; F2000 left every card behind (3 failed picks in a row). Lift to Z 40 before travelling. Pick+place ~7.5 s. Vacuum holds ~20 s; one carry with photos mid-way reached 17 s, don't stop mid-carry.
- 2026-11-01 16:40 (claude): Stacking: the cup can't rotate cards; pick pairs within a few degrees. 6 cards stacked into one pile with ~2-4 mm misalignment.
- 2026-11-01 16:40 (claude): Esper: 130 x 130 x 100 plywood, 3 mm off the ground, corner caps 2 mm proud (105 top). Travel height 110. Sideways bumps OK, never press down on it. Its toggle switch is at the back.
- 2026-11-01 16:40 (claude): Cameras: cam 1 (angled) is the one that locates things; cam 0 (low side) only for watching picks. Calibrated grid was +-50 mm around (25, 50) at Z 15-120: accuracy is best there. The camera's head position was 20-33 mm off at Z 120 near (-60, 60), so re-anchor uses the saved position by default.
- 2026-11-01 16:40 (claude): Restarting the hub resets the Uno (position lost, Alarm). Unlock, then re-anchor; it restores the saved position, exact if nothing moved.
- 2026-11-01 16:54 (claude): Origin moved (Nov 1): X/Y 0,0 is now the centre of the area inside the board markers (shifted by -9.8, -18.0 from the first touch-off). Cup bounds: X -216 to 216, Y -195 to 195 (inside the markers' inner edges); the hub refuses moves outside and stops jogs at the edge.
- 2026-11-01 16:54 (claude): The automatic camera-bump correction was turned off: a moved marker made it warp everything (marker 1 read as 667, 600). camera_moved_px is now only a warning; re-measure bounds (POST /api/calibration/bounds) after moving markers on purpose, recalibrate after moving a camera.
- 2026-11-01 16:54 (claude): Accuracy check after the origin shift: cup ~4-5 mm from a card centre at (99, -52). Earlier ~2-3 mm.
- 2026-11-01 16:54 (claude): (old, replaced Nov 2) Park spot that keeps cam 1's view clear: head at (129.8, 88, 120). The user's directions: their right = +X, away from them = +Y (cam 1 looks from the -X side).
- 2026-11-01 16:56 (claude): Suction cup is 15 mm across (sold as 12 mm), 2-layer bellows.
- 2026-11-01 17:23 (claude): Esper calibration (Nov 1, speed 800, accel 1000, on the black board): forward 0.048 mm per half-step (1024 -> 49.1 mm, 2048 -> 98.6 mm), drives straight (0.7 deg drift per move), ~30 mm/s. Turning in place: left 0.0351 deg per half-step (1024 -> +35.9), right 0.0373 deg per half-step (4550 -> -169.9). So ~10,260 (left) / ~9,650 (right) half-steps for a full turn. Esper's marker is a few mm off its turning centre (it shifts 5-18 mm during a turn).
- 2026-11-01 17:23 (claude): Esper's marker reads 27.8 mm at Esper's real height (board markers read 29.5): either it's printed smaller than 30 mm or Esper sits lower there. The scene's Esper height (from marker size) says ~80 mm instead of 103; positions are fine, heights aren't. Ask the human to measure it.
- 2026-11-01 17:23 (claude): Esper's flipper is on its front face, 42 mm from the right wheel, sweeping in the plane of the face: 20 = flat on the table along the front edge (rest; can't go lower), 60 = sideways at mid-height, 110 = over the top. Wave: 80, then 110/60 x3 at speed 600, back to 20 at 300.
- 2026-11-01 17:23 (claude): Speaker works: POST /api/say {text} (espeak-ng on the SoundCore 2). Esper's camera: GET esper.local/capture, 640x480 in ~1 s, from ~6 cm up.
- 2026-11-01 17:23 (claude): Cam 1 moved ~20-25 px (about 10 mm on the board) between 17:20 and 17:40 on Nov 1 (camera_moved_px 29). Recalibrate before precise picks.
- 2026-11-01 19:07 (claude): Recalibrated (Nov 1 evening) after cam 1 had drifted 57 px: grid +-50 mm around (60, 60) at Z 120/67.5/15, cam 1 0.88 px, cam 0 0.93 px. Cup then landed within ~1-2 mm of a card centre. Calibration now takes ~41 s (rapid moves within a level) and keeps the board touch-off and bounds. Recalibrate whenever camera_moved_px climbs past a few px.
- 2026-11-01 19:07 (claude): Board re-measured with markers 0, 1, 2: cup bounds X +-210, Y +-191 (origin re-centred by 6.0, -3.4: the board itself had shifted).
- 2026-11-01 19:07 (claude): Esper's flipper is on its RIGHT side, ahead of the right wheel (not on the front face): ~60 deg lies back over the wheel, ~110 up and over, 20 at rest down at the table. The 3D view draws it there.
- 2026-11-01 19:10 (claude): Correction: the flipper is pivoted by the right wheel near the front corner, with the servo at 45 deg, so the blade sweeps around that corner onto the face: 20 low across the front edge (rest), 60 across the face, 110 over the top.
- 2026-11-01 19:21 (claude): Turning cards with Esper works (Nov 1): 6 cards, each turned to 90.5 deg on Esper's top and stacked, ~35 s per card. Recipe: (1) turn the empty Esper so the card will land square to it (a card at ~45 deg to Esper lands tilted on a corner cap and the pick fails); (2) put the card on Esper's turning centre at cup Z 105.5 and drop; (3) turn Esper by the angle needed; (4) look with cam 1 where the card really is on Esper's top (map at board + 103.5 mm; it ends 6-16 mm from the centre); (5) pick it there at Z 102, grip?pump_s=2, peel at F600; (6) place on the stack at 1.2 + 0.3 n + 0.3.
- 2026-11-01 19:21 (claude): Esper's turning centre: 8.6 mm forward of its marker centre, 0.5 mm left (in Esper's frame). Turn rates with the recalibrated camera: left 0.0377, right 0.0371 deg per half-step (Esper's heading came out within 0.3 deg of the step-count estimate).
- 2026-11-01 19:21 (claude): Esper's plywood top is at 103 mm (cards lie on it, between the corner caps, which stand 2 mm higher at 105). The hub lets the cup go down to 101.5 over Esper (a 1.5 mm squeeze), no lower.
- 2026-11-01 19:21 (claude): Keep Esper's turning centre at least ~20 mm inside the cup bounds: a card on Esper's top can end up near the edge after a turn (one was 0.07 mm outside, X -210.47, and the hub refused the pick).
- 2026-11-01 19:21 (claude): Hub restarts don't reset the Uno any more (stty -hupcl in hub.service): GRBL keeps its position and stays unlocked; no re-anchor needed after a deploy.
- 2026-11-01 19:25 (claude): Esper home (old, moved Nov 2): turning centre at (-239.9, -1.7), facing +X (into the board): the middle of the left margin, in line with board markers 0 and 2. POST /api/esper/home drives it there with the camera checking; first run took one move (turn 52.8, back 114 mm), 16 s, landed 0.4 mm and 0.7 deg off.
- 2026-11-02 04:41 (claude): Card flip with Esper's flipper (Nov 2, first try worked, 1 for 1): - Esper square to the card, flipper at rest (20). Card face-down, LONG side along Esper's heading. - Crane places the card in front of Esper's face: card centre 116 mm ahead of Esper's marker, 23 mm to Esper's right; near edge ~5 mm ahead of the front corner caps (so it rests on the bent part lying on the table). Drop from cup Z 10. - Flipper 20 -> 70 at speed=30: the bent part lifts the near edge, card leans at ~45 deg. - Drive forward 95 mm total at full wheel speed (800/1000). At 70 mm the card stands vertical; the last 25 mm tips it over. - Card lands flat, face-up, same angle, ~100 mm further forward than placed. - Then back up 50 mm BEFORE lowering the flipper (else it comes down on the card), flipper -> 20 at speed=30. - Before the run GRBL was in Alarm with MPos 0 (it had reset); $X unlocked it, the saved position was right.
- 2026-11-02 04:46 (claude): Card flip, v2 (Nov 2, 3 for 3 now): lift and roll TOGETHER. Card centre 114 mm ahead of Esper's marker, 23 mm to its right (2 mm closer than v1), long side along Esper's heading, Esper squared to the card first. Then at once: flipper 20->70 at speed=60 and drive 95 mm at wheel speed 640 (80%), accel 1000; takes ~3.9 s. Card lands flat, ~100 mm on, turned a further 4-7 deg clockwise (from above) and ~10 mm to Esper's right of straight ahead. Then back 50 mm, flipper -> 20 at speed=60. Flipper/wheel speed (from the user): full speed trips Esper's connection ~5% of the time; ~80% of max is fine. Picking a card that was flipped face-up near Esper's home lane: Z -0.8 didn't grab (twice); Z -2 at F600 + pump_s=2 did; Z -1.5 grabbed fine for the next ones.
- 2026-11-02 04:53 (claude): Card flip, more runs (Nov 2): 8 for 8 flips, all landed flat. Every flip turns the card clockwise (from above): ~7 deg with the card 23 mm right of Esper's marker, 3.6 deg at 15 mm right, 5.5 deg at 8 mm right (+-2 deg noise). Use 15 mm right for now. The user says the flipper ("hand") isn't straight yet and will be fixed later; re-measure after. Because Esper squares to the card each time, the turn adds up flip after flip and the landing walks toward -Y; re-square the card (Esper turn, or ask a person) once it's more than ~20 deg off. Snapshot both cameras at each stage of a run (placed, during the roll, done) and keep them for review.
- 2026-11-02 04:55 (claude): Tried curving the roll to cancel the clockwise turn (Nov 2): Esper turning anticlockwise 3.6 deg during the roll -> card still turned -4.8 deg; 9.6 deg -> card -5.9 deg. The card doesn't follow Esper's turn; its twist is set by the flipper itself. Roll straight (curve 0) until the flipper is fixed. flip lab script supports a CURVE_DEG arg (unequal wheel steps; /step finishes both wheels together).
- 2026-11-02 05:27 (claude): New hand (Nov 2): level and centred on the face at 65 deg. Recipe: flipper to rest (20) FIRST, then place the card (centre 114 mm ahead of Esper's marker, centred: 0 mm right), then together flipper 20->65 at speed=60 + drive 95 mm at 640; back 50, flipper to 20. 3 for 3, card turns -3.8, -2.8, -5.0 deg (clockwise from above) per flip. Mistake to avoid: the flipper had been left at 65; the card was placed in front of a raised hand, then pushed and run over by Esper. Always lower the hand before placing.
- 2026-11-02 09:29 (claude): Picked and put back an AirPods case (21 mm tall, rounded) Nov 2: cup at its top centre, press to Z 16 (5 mm into the cup; Z 19.5 only touched and did not seal), grip with the pump left on, 1.5 s, lift F600 to 60, put down at Z 21.5, drop. Worked first time at the right spot. Cameras recalibrated over a 5x5 grid +-130 mm at cup Z 110/75/40 (cam 1 1.7 px, cam 0 2.9 px). Locating it: SAM found it from cam 1 only as "white object". Two-camera carving gave its height right (21.5 vs 21) but cam 1s top point was 20 mm off in X (said -23, real -3); the carved footprint said -6. Use the footprint centre for x, y.
- 2026-11-02 15:49 (claude): Poker chips (40 mm, ~3.3 mm thick, red 5s and white 1s): find with 'red poker chip|red object' / 'white poker chip|white object' (cam 1, head parked first: the cup over the middle hides a row). Pick: cup to pick.x, pick.y at Z 5, G1 Z1.5 F600, plain grip (pump on), peel G1 Z5 F1500, rapid to Z 20. Place on a chip: G1 to 7.8 (1.2 mm above the stack top + the held chip) at F1200, drop, Z 40. Worked first try Nov 2; the stack came out ~3-4 mm off centre, the same as the pick offset, so it's fine for chips. Each chip in a stack adds ~3.3 mm.
- 2026-11-02 15:49 (claude): Dominoes (~25 x 50 mm, ~8 mm tall): 'domino|white object' finds all of them; see miscounted (said 6, there were 5), so trust find's count over see's.
- 2026-11-02 16:10 (claude): Cup accuracy over find pick points, after recalibrating and setting TIP_OFFSET (-2.4, -19.7), measured by centring the cup by eye (the user said toward/away from them): centred on chips at (-7, -45) and (68, -8); 1-2 mm off at (28, -124), nearest the front; 6 mm short at (68.5, 109) on the far side: the chip was 6 mm further +Y (away from the front) than find said, twice. So far-side picks land toward the front: fine for chips and cards with the 15 mm cup; for neat stacks past y ~80 aim ~6 mm further +Y.
- 2026-11-02 16:08 (claude): Stacked chips: find gives no height, and Muse with ask= miscounts stacks from cam 1 crops (said 5 for singles, 1 for a double). What works: the outline length. A chip is 40 mm across, so board h - w is how much of its side cam 1 sees: 1-2 mm = single, 6-8 mm = double (Nov 2: all 8 chips right, 3 red doubles, 2 red singles, 1 white double, 2 white singles). Triples untested; expect ~11-13. Cam 0 (the low side view) shows stacks plainly if in doubt. Height to pick from: 3.3 mm per chip.
- 2026-11-02 16:40 (claude): Esper home moved to (0, 210), heading -90 (facing the front, toward the players): the middle of the far margin, past the play area. The user chose that side: at the old left-margin home Esper sat right in cam 0's view across the board. The calibration grid still clears it (it refuses Esper within ~198 mm of the middle in Y).
- 2026-11-02 17:10 (claude): Park the head at the BACK right: (190, 150) at Z 120 (the user: the back is the best way out of the view). From there cam 1 sees the whole board and Esper at its home (0, 210); parked at the front (150, -150) the Z bar hid Esper in the middle, and at (129.8, 88) the wires hung over Esper's home.
- 2026-11-02 17:35 (claude): Z re-zeroed Nov 2 on top of a card at (-78, -46): Z 0 had crept ~1 mm high (the cup only touched at the old Z -1.0). After it, the card recipe (Z -1.5, pump_s=1) lifted the 8 of spades first try.
- 2026-11-03 09:01 (claude): Recalibrated cam 1 Nov 3 evening (3D page Calibrate, +-90 mm, 3x3x3): cam 1 1.08 px, cam 0 1.57 px. camera_moved_px stays ~16 because marker 3 (front right) was hidden: re-measure bounds once all four markers show.
- 2026-11-03 09:01 (claude): Chip stacks from /api/scene (free, cam 1 colours + cylinder fit): counts right for 1-6 (Nov 3: height = 3.47 n - 1.04 mm as fitted). Touch the top of a stack of n at cup Z 3.3 n - 1.5 (worked on 1-6; the 3 pressed a bit more). Pointing: cup centred on a flat card; on stacks it landed 0-4 mm toward the front (mean 2.3), so scene chip x, y now carry a +2.3 mm Y shift (chips.SHIFT). Stacks must stand ~1 cm apart: touching ones drop out of the scene.
- 2026-11-03 09:01 (claude): Old deck (worn, curled cards) fits ~0.5 mm per card in the scene (33 cards ~16 mm); a single curled card can fit 4 mm tall, so decks start at 5 mm.
- 2026-11-03 09:07 (claude): Nov 3 evening: after recalibrating over +-90 mm only, scene chip heights shifted outside that area (a 6-stack at x -169 read 21.6 mm = 7). The 3.47 n - 1.04 count line was measured before that recalibration. Until a whole-board calibration (5x5, +-130) and a re-measured line, trust scene chip counts near the middle; off-centre ones can be 1 chip off.
- 2026-11-03 11:46 (claude): Nov 3 evening: head marker replaced and cameras recalibrated; the cup then landed 4.5 mm right of a chip in the middle, so TIP_OFFSET X went -2.4 -> 2.1 (Y -19.7 kept: the 2.5 mm it sat forward matched the chip fit bias chips.SHIFT). Re-measure the same way after any marker swap: point at a chip in the middle using its raw centre (minus chips.SHIFT), nudge to centre, the X/Y difference goes into TIP_OFFSET.
- 2026-11-03 11:57 (claude): Nov 3 night: chip stacks are counted better the further they are from cam 1 (front left, about -312, -125, 440 mm up): near it the view is steep and a stacks side barely shows (a 2-stack near the middle read as 1). Cam 0 cant help yet: its model is off by 22-37 px at board level (it saw the head at only 29 of 75 calibration stops, and no stop is near board level), so side heights disagreed. Z and X/Y steps are accurate (100 mm Z measured 100). Fixing cam 0 needs it aimed at more of the board and its own calibration.
- 2026-11-03 12:00 (claude): Nov 3 night: TIP_OFFSET X set to -0.9 (2.1 from centring by eye over a chip landed picks 3 mm left). Centring the cup from 2 mm above by eye is not precise to better than ~3 mm: judge by where picks and placed chips actually land.
- 2026-11-03 12:20 (claude): Nov 3 night: after recalibrating, a white 7-stack read 6 (19.5 mm). Not the colour mask (the pixels a true 7-stack would add are mat-coloured): cam 1s model overstates how much a stacks side shows. Since this calibration the fit reads ~0.88 x true - 1.4 mm, so the chip count rule is now (h + 1.4) / 2.98 (eyes.KNOWN chip unit/short). This rule depends on the calibration: after every calibration put one known stack of 5+ and a single on the board and re-check.
- 2026-11-03 12:25 (claude): Nov 3 night: chip count rule refitted on 1s, 2s, 7s, a 9 and a 10: height = 3.13 n - 1.74 (eyes.KNOWN chip unit 3.13, short 1.74); all within 0.5. The scene also gives count_raw (unrounded): 7.0 is sure, 7.4-7.6 is borderline. Re-check with a 5+ stack and a single after each calibration.
- 2026-11-03 12:35 (claude): Nov 3 night: SAM find has its own chip count rule, (h + 1.38) / 3.38 (eyes.KNOWN chip sam), since its outlines read ~0.5-1.2 mm taller than the scene colour patch. Checked on three 3-stacks and two singles: all right (a single at 1.3 is marked sure: false and planned as 2). Re-check both rules after each calibration.
- 2026-11-03 12:58 (claude): Nov 3 night: scene chip counts are now by colour: white 3.20 n - 1.83, red 3.45 n - 1.83 (a red chips shaded side stays red and counts in full; a white ones partly drops out). Confirmed: white 1s, 2s, 7s, an 8; red 9. Scene cards: touching cards are split (watershed) so a row dealt close is found; face up/down is decided by matching a learned card back (cards/back.png, learned from the first clearly blue card) instead of the blue share, which sat near its threshold.
- 2026-11-03 13:25 (claude): Nov 3 night: the scene finds face-down cards by their blue back panels (vision._backs: ~52 x 76 mm inside the white border, brightness over 140), so touching cards are each found; face up or down comes from the learned back (cards/back.png). Checked: 7 face-down cards dealt touching, all found and all face down, steady over 10 reads, plus the deck. A bright, bluish glare on the mat once merged into backs: keep lamps from reflecting off the mat.
- 2026-11-03 14:22 (claude): Nov 3: Esper goto refusing with in_the_way around (-30, 119) is the gantry wiring hanging into cam 1 view, not a real object (the user). Move the head (park) or move Esper around it. Esper may drive over cards as long as it does not pick them up; the gantry must mind the flipper arm sticking out in front. Esper-s assumed place (raw /step moves are not counted) can be far off: a card was picked from right in front of/under Esper because the scene still had Esper 30+ mm back. Re-see Esper (goto, or wait for assumed: false) before any crane move near it.
- 2026-11-03 14:25 (claude): Nov 3: park the head at (190, 230) Z 110 (the back right corner) whenever Esper must be seen: at (190, 150) the gantry wiring hid Esper marker from cam 1 and the scene fell back to an assumed (wrong) place. Flip with the peek moves works: 5♦ face up, turned 2°, 27 s (poker guide).
- 2026-11-03 14:28 (claude): Nov 3: proper spots. Esper home saved at its usual peek/flip spot, about (-26, 222) facing the players (heading -87), the middle of the far side; send it there (api/esper/home) after a peek or flip. Park the head at (120, 230) Z 110 for jobs with Esper: (190, 150) lets the gantry wiring hide Esper marker, (190, 230) hides the back-right board marker (goto then refuses). After a flip put the card at its proper spot. A face-up card that has just been flipped needed the cup pressed to Z -2 to lift (Z -1.5 left it behind). goto and the scene disagree by ~8 mm in Y about Esper near the back edge.
- 2026-11-03 14:29 (claude): Nov 3: when the scene cards look strange (a card missing, a deck where there should be a card, a wrong face, cards touching or overlapping, a count that does not add up), check with SAM: GET /api/find?what=playing card|white object (with ask= to read them), with the head parked. The free scene is fast but makes mistakes; SAM is the second opinion.
