ahamal/magic-table/software/hub/server.py

"""Table hub web server: GRBL, the gripper, the cameras, vision and speech-to-text over HTTP + a
live WebSocket, the jog page, the talk page and the 3D scene page.

Run on the Pi:  python serve.py   (HTTP and HTTPS both on :8000; see serve.py)
"""

import asyncio
import threading
import contextlib
import json
import math
import os
import time
import urllib.request
from pathlib import Path

import cv2
import numpy as np
from fastapi import FastAPI, HTTPException, Request, WebSocket, WebSocketDisconnect
from fastapi.responses import FileResponse, PlainTextResponse, RedirectResponse, Response, StreamingResponse
from fastapi.staticfiles import StaticFiles
from pydantic import BaseModel

import camera
import cards as cardlib
import chips as chiplib
import eyes
from grbl import REALTIME, Grbl
from esper import CENTRE as ESPER_CENTRE, CLOSE_MM as ESPER_CLOSE, EsperLink
from gripper import SEQUENCES, Gripper
from talk import Chat, TranscribeError
from vision import ESPER_SIZE, Vision, to_xy
from voice import Voice

HERE = Path(__file__).parent
grbl = Grbl(port=os.environ.get("GRBL_PORT", "/dev/ttyACM0"))
cameras = []  # one per camera the Pi found at boot
app = FastAPI(title="Magic Table hub")
clients = set()
loop = None


def broadcast(event):
    """Called from GRBL threads; hands the event to the asyncio loop."""
    if loop:
        for ws in list(clients):
            asyncio.run_coroutine_threadsafe(_send(ws, event), loop)


gripper = Gripper(grbl, broadcast)
chat = Chat(broadcast)
voice = Voice(broadcast)
esper = EsperLink()
vision = None  # needs the cameras, so it starts at startup


async def _send(ws, event):
    try:
        await ws.send_json(event)
    except Exception:
        clients.discard(ws)


@app.on_event("startup")
async def startup():
    global loop
    loop = asyncio.get_running_loop()
    grbl.listeners.append(broadcast)
    grbl.start()
    cameras.extend(await asyncio.to_thread(camera.start_all))
    global vision
    vision = Vision(cameras, grbl, broadcast, esper)
    vision.cards = cardlib.Cards()
    vision.chips = chiplib.Chips()
    asyncio.create_task(vision.cards.watch(eyes.ask))
    vision.run()


# ---- API ----

class Line(BaseModel):
    line: str


class Jog(BaseModel):
    x: float = 0
    y: float = 0
    z: float = 0
    feed: float = 3000


class Move(BaseModel):
    x: float | None = None
    y: float | None = None
    z: float | None = None
    feed: float | None = None  # None = rapid (G0)


def run(line, timeout=30):
    reply = grbl.send(line, timeout)
    if line.strip().upper() in ("$X", "$H") and reply == "ok":
        close_valve()
    return {"line": line, "reply": reply}


def close_valve():
    """A reset can leave SpnDir (the valve) set; close it once G-code runs again."""
    if gripper.valve:
        gripper.run("valve_off")


@app.get("/api/status")
def status():
    return {**grbl.status, "homed": grbl.homed}


@app.get("/api/settings")
def settings():
    return grbl.settings


@app.post("/api/send")
async def send(body: Line):
    """Any G-code or $ command. Waits for GRBL's ok/error."""
    return await asyncio.to_thread(run, body.line)


# Work Z is the cup's height above the board (0 = touching it). Never past the top of the Z
# travel, never more than the 2 mm squeeze a card pick can need (the cup's top is soft; -1.5
# picks a card, -2 a stubborn one: agent/table.md). No limit switches, so these are the only stops.
Z_MIN, Z_MAX = -2.0, 150.0


def z_now():
    return (grbl.status.get("WPos") or [0, 0, 0])[2]


UNANCHORED = {"line": "", "reply": "error:GRBL reset, so its position is unknown: $X, then POST /api/calibration/reanchor"}


@app.post("/api/jog")
async def jog(body: Jog):
    """Relative jog ($J). Cancel early with /api/realtime/jog_cancel. Z jogs stop at the Z limits."""
    if vision and vision.needs_reanchor:
        return UNANCHORED          # the limits are in work coordinates, which a reset lost
    if body.z:
        z = z_now()
        body.z = min(body.z, Z_MAX - z) if body.z > 0 else max(body.z, Z_MIN - z)
    if vision and (body.x or body.y):
        body.x, body.y = vision.clip_jog(body.x, body.y)   # the cup stops at the board bounds
    if max(abs(body.x), abs(body.y), abs(body.z)) < 0.01:
        return {"line": "", "reply": "error:at a limit (Z or the board bounds)"}
    axes = "".join(f"{a}{v:.3f}" for a, v in (("X", body.x), ("Y", body.y), ("Z", body.z)) if abs(v) >= 0.001)
    if not axes:
        raise HTTPException(400, "nothing to jog")
    if vision and not vision.jog_ok(body.x, body.y, body.z):
        return {"line": "", "reply": "error:won't press into Esper"}
    return await asyncio.to_thread(run, f"$J=G91 G21 {axes} F{body.feed:.0f}")


@app.post("/api/move")
async def move(body: Move):
    """Absolute move in work coordinates (Z = cup height above the board, Z_MIN to Z_MAX)."""
    axes = "".join(f"{a}{v:.3f}" for a, v in (("X", body.x), ("Y", body.y), ("Z", body.z)) if v is not None)
    if not axes:
        raise HTTPException(400, "nothing to move")
    if vision and vision.needs_reanchor:
        return UNANCHORED
    if body.z is not None and not Z_MIN <= body.z <= Z_MAX:
        return {"line": "", "reply": f"error:Z {body.z:g} is outside {Z_MIN:g} to {Z_MAX:g}"}
    if vision:
        w = grbl.status.get("WPos") or [0, 0, 0]
        hx = w[0] if body.x is None else body.x
        hy = w[1] if body.y is None else body.y
        if not vision.cup_in_bounds(hx, hy):
            return {"line": "", "reply": "error:that puts the cup outside the board bounds"}
    if vision and vision.scene.get("esper"):
        # plan from where the head will really be: let queued moves finish first (WPos lags them)
        await asyncio.to_thread(grbl.send, "G4 P0", 60)
        lines, why = vision.plan_move(body.x, body.y, body.z, body.feed)
        if why:
            return {"line": "", "reply": f"error:{why}"}
        if lines:   # around Esper: up to travel height, across, back down
            replies = [await asyncio.to_thread(run, l) for l in lines]
            return {"line": " / ".join(lines), "reply": replies[-1]["reply"]}
    cmd = f"G90 G1 {axes} F{body.feed:.0f}" if body.feed else f"G90 G0 {axes}"
    return await asyncio.to_thread(run, cmd)


class Tip(BaseModel):
    x: float
    y: float
    z: float | None = None      # cup tip height above the board, mm (work Z 0 = touching it)
    feed: float | None = None   # None = rapid


@app.post("/api/tip")
async def tip(body: Tip):
    """Put the cup tip (not the head) at board X/Y, optionally at a height. The cup sits in
    front of the Z extrusion (vision.TIP_OFFSET), so the head goes there minus that offset.
    Same Esper rule as /api/move."""
    hx, hy = vision.head_for_tip(body.x, body.y)
    return await move(Move(x=hx, y=hy, z=body.z, feed=body.feed))


@app.post("/api/home")
async def home():
    reply = await asyncio.to_thread(grbl.home)
    if reply == "ok":
        await asyncio.to_thread(close_valve)
    return {"line": "$H", "reply": reply}


@app.post("/api/realtime/{name}")
def realtime(name: str):
    """status, hold, resume, reset, jog_cancel. Sent immediately, no queue."""
    if name not in REALTIME:
        raise HTTPException(404, f"unknown: {name}")
    if vision and name in ("hold", "reset"):
        vision.stop()   # a running calibration stops here, with no further moves
    return {"sent": grbl.realtime(name)}


@app.get("/api/gripper")
def gripper_state():
    return gripper.state


@app.post("/api/gripper/{name}")
async def gripper_command(name: str, pump_s: float | None = None):
    """pump_on, pump_off, valve_on, valve_off, grip, drop, stop. Queued after any motion.
    grip?pump_s=3 runs the pump 3 s then stops it; the vacuum holds ~20 s (enough for a card)."""
    if name not in SEQUENCES:
        raise HTTPException(404, f"unknown: {name}")
    return await asyncio.to_thread(gripper.run, name, pump_s)


def get_camera(cam):
    if not 0 <= cam < len(cameras):
        raise HTTPException(404, f"no camera {cam}; there are {len(cameras)}")
    c = cameras[cam]
    if c.cam is None:
        raise HTTPException(503, f"camera {cam} didn't start: {c.error}")
    return c


@app.get("/api/cameras")
def list_cameras():
    return [c.info for c in cameras]


@app.get("/api/capture")
async def capture(cam: int = 0):
    """A fresh full-size JPEG from one camera."""
    c = get_camera(cam)
    jpg = await asyncio.to_thread(c.capture)
    if jpg is None:
        raise HTTPException(503, f"camera {cam} stopped")
    return Response(jpg, media_type="image/jpeg", headers={"Cache-Control": "no-store"})


history = eyes.History()   # every see, find and check, kept on disk


async def _picture(cam):
    """A fresh JPEG from cam 0, 1 or "esper", and that camera's model (None for Esper)."""
    if cam == "esper":
        try:
            return await asyncio.to_thread(lambda: urllib.request.urlopen(f"{esper.url}/capture", timeout=5).read()), None
        except OSError as e:
            raise HTTPException(503, f"Esper's camera didn't answer: {e}")
    c = get_camera(int(cam))
    jpg = await asyncio.to_thread(c.capture)
    if jpg is None:
        raise HTTPException(503, f"camera {cam} stopped")
    P, _ = vision._cam(int(cam))
    return jpg, P


def _eyes_done(kind, result, jpegs, by):
    rec = history.add({"kind": kind, "at": time.time(), "by": by, **result}, jpegs)
    broadcast({"type": "vision", **rec})
    return rec


async def _meta(coro):
    try:
        return await coro
    except eyes.EyesError as e:
        raise HTTPException(502, str(e))
    except HTTPException:
        raise
    except Exception as e:  # network trouble reaching Meta
        raise HTTPException(502, f"couldn't reach Meta: {e}")


async def _see_or_ask(jpg, ask, effort):
    if ask:
        return {"answer": await _meta(eyes.ask(jpg, ask, effort))}
    return {"things": await _meta(eyes.see(jpg, effort))}


@app.get("/api/see")
async def see(cam: str = "1", ask: str | None = None, effort: str = "minimal", by: str = "agent"):
    """What's on the board (Muse Spark, one fresh picture): {things: [{name, count}]}, names that
    work with /api/find. With `ask`, Muse Spark answers that question about the picture
    instead: {answer}. ~2-3 s."""
    if effort not in eyes.EFFORTS:
        raise HTTPException(400, f"effort is one of {', '.join(eyes.EFFORTS)}")
    jpg, _ = await _picture(cam)
    t0 = time.time()
    esper_face("thinking")             # Esper "thinks" while Muse looks (a few seconds)
    try:
        res = await _see_or_ask(jpg, ask, effort)
    finally:
        esper_face("eyes")
    return _eyes_done("see", {"cam": cam, "ask": ask, **res, "took_ms": round((time.time() - t0) * 1000)},
                      {cam: jpg}, by)


def _robot_boxes():
    """The head and Esper as boxes of work-coordinate corners, where they're tracked now, so find
    can tell a match that is the robot from a loose thing (eyes.robot_masks)."""
    sc, tz = vision.scene, (vision.cal or {}).get("table_z")
    if tz is None or not sc.get("head"):
        return None
    box = lambda cx, cy, hx, hy, z0, z1, a=0.0: [
        (cx + sx * hx * math.cos(a) - sy * hy * math.sin(a), cy + sx * hx * math.sin(a) + sy * hy * math.cos(a), z)
        for sx in (-1, 1) for sy in (-1, 1) for z in (z0, z1)]
    h = sc["head"]
    out = {"cup": box(h["tip_x"], h["tip_y"], 12, 12, h["tip_z"], h["z"]),
           "head": box(h["x"] + 11, h["y"], 12, 19, h["z"] - 35, h["z"] + 250)}   # Z extrusion, marker card on its left face
    m = sc.get("esper")
    if m:
        half = max(ESPER_SIZE[:2]) / 2 + 8
        out["esper"] = box(m["x"], m["y"], half, half, tz, tz + ESPER_SIZE[2], math.radians(m["heading"]))
    return out


@app.get("/api/find")
async def find(what: str, cam: str = "1", ask: str | None = None, effort: str = "minimal", height: bool = False,
               diameter: float | None = None, by: str = "agent"):
    esper_face("focused")              # Esper squints and scans while SAM (and Muse) work
    try:
        return await _find(what, cam, ask, effort, height, diameter, by)
    finally:
        esper_face("eyes")


async def _find(what: str, cam: str = "1", ask: str | None = None, effort: str = "minimal", height: bool = False,
                diameter: float | None = None, by: str = "agent"):
    """Where things are, for picking (SAM 3.1, one fresh picture from `cam`: 1 by default, 0, or
    "esper"). what: one or more names, comma-separated (from /api/see, or your own); fallbacks
    after "|" are tried in order when a name finds nothing: what=earbuds case|white object
    (/api/see gives them). Each item: what, matched, box and outline (pixels), and from a
    calibrated camera its footprint on the board {x, y, w, h, angle}, on_board, and pick
    {x, y, clear_mm}: put the cup at x, y; clear_mm is how much room the cup (15 mm) has.
    Esper's camera gives pixels only. ask: a question Muse Spark answers about each item from
    its crop (answer). height=true (cam 1): cam 0, low at the side, looks at the same moment
    and each item gets height_mm, how tall it stands (None where cam 0 can't see it whole).
    Off by default: on this build cam 0's board level is off (Nov 2), so it finds nothing yet.
    Known things (cards, decks, poker chips, by name) come placed for their height: an angled
    camera sees a tall thing's side, which stretches its flat footprint away from it and pulls the
    centre along, so find fits the solid of known size that matches the outline instead. Their
    board is where they really stand, with height_mm, count (chips in a stack; count_raw unrounded,
    with the cup's pick_z and place_z for it, planned for the taller stack when not sure), fit (0-1) and the
    stretched footprint in flat. A fit under 0.85 (touching stacks, cut off) leaves board flat.
    diameter=<mm> does the same for any other round upright thing (a can, a cup). A low fit:
    touching things seen as one, or not a cylinder. ~2-3 s, ~3-5 s with height."""
    phrases = [p.strip() for p in what.split(",") if p.strip()][:6]
    if not phrases:
        raise HTTPException(400, "say what to find, e.g. what=playing card")
    if effort not in eyes.EFFORTS:
        raise HTTPException(400, f"effort is one of {', '.join(eyes.EFFORTS)}")
    side = cam == "1" and height and vision._cam(0)[0] is not None
    shots = await asyncio.gather(_picture(cam), *([_picture("0")] if side else []))
    jpg, P = shots[0]
    tz = (vision.cal or {}).get("table_z")
    if tz is None:
        P = None
    res = await _meta(eyes.find(jpg, phrases, P, tz, (vision.cal or {}).get("bounds"), ask, effort, _robot_boxes(),
                                shots[1] if side else None, diameter))
    return _eyes_done("find", {"cam": cam, "what": phrases, "ask": ask, **res},
                      {cam: jpg, **({"0": shots[1][0]} if side else {})}, by)


@app.get("/api/cards")
async def read_cards(effort: str = "minimal"):
    """The face-up cards on the board, named, from cam 1 (the scene's last look): the cache on
    the Pi names a card it has seen before in a few ms, no API; any other is read by Muse Spark
    from its flattened face (~1-2 s, all at once) and, if Muse is sure, cached. Each: {x, y,
    angle, card ("5♣"), by ("cache" or "muse"), score (the cache's match, 0-1), confidence
    (Muse's)}. /api/scene's cards carry the cached names too. Face-down cards aren't named."""
    if effort not in eyes.EFFORTS:
        raise HTTPException(400, f"effort is one of {', '.join(eyes.EFFORTS)}")
    await asyncio.to_thread(vision.update)
    return {"cards": await _meta(vision.cards.read(eyes.ask, effort)), "cached": len(vision.cards.index)}


@app.delete("/api/cards")
async def forget_cards():
    """Empties the card cache (a new deck)."""
    vision.cards.forget()
    return {"ok": True}


@app.get("/api/find/shapes")
async def find_shapes(n: int | None = None, effort: str = "minimal", by: str = "agent"):
    """The things of a find (`n`, the last by default) as low-poly models for the 3D scene: Muse
    Spark describes each from find's picture as a few solids; the footprint gives place, size and
    turn. items: [{id, what, board, shape: {height_mm, axis, top, parts}}]. ~1-2 s."""
    res = history.get(n) if n else history.last("find")
    if not res or res["kind"] != "find":
        raise HTTPException(404, "no such find: GET /api/find first")
    P, _ = vision._cam(int(res["cam"])) if res["cam"] in ("0", "1") else (None, None)
    jpg = history.picture(res["n"], res["cam"])
    on = [i for i in res["items"] if i.get("board") and i.get("on_board") is not False][:12]
    if P is None or jpg is None or not on:
        raise HTTPException(400, "that find has nothing on the board to model")
    t0 = time.time()
    img = cv2.imdecode(np.frombuffer(jpg, np.uint8), cv2.IMREAD_COLOR)
    tz = vision.cal["table_z"]
    got = await asyncio.gather(*(_meta(eyes.shape(eyes.straight(img, i, P, tz), i["what"], effort)) for i in on),
                               return_exceptions=True)
    items = [{"id": i["id"], "what": i["what"], "board": i["board"],
              **({"error": str(getattr(g, "detail", g))} if isinstance(g, Exception) else {"shape": g})}
             for i, g in zip(on, got)]
    return _eyes_done("shape", {"find": res["n"], "cam": res["cam"], "items": items,
                                "took_ms": round((time.time() - t0) * 1000)}, {}, by)


@app.get("/api/find/check")
async def find_check(id: int, by: str = "agent"):
    """Did item `id` of the last find leave its spot? A fresh picture from the same camera,
    compared with find's inside the item's outline: {gone, changed}. Use it with the thing
    lifted: gone false means the pick didn't take. No API call, ~0.5 s."""
    res = history.last("find")
    if not res:
        raise HTTPException(404, "no find to compare with: GET /api/find first")
    it = next((i for i in res["items"] if i["id"] == id), None)
    if it is None:
        raise HTTPException(404, f"no item {id} in the last find")
    cam = res["cam"]
    now, _ = await _picture(cam)
    dec = lambda j: cv2.imdecode(np.frombuffer(j, np.uint8), cv2.IMREAD_GRAYSCALE)
    c = eyes.changed(dec(history.picture(res["n"], cam)), dec(now), it["outline"])
    return _eyes_done("check", {"id": id, "find": res["n"], "what": it["what"], "cam": cam,
                                "gone": c is not None and c > eyes.GONE, "changed": c}, {}, by)


@app.get("/api/vision/history")
def vision_history(limit: int = 50):
    """The latest see, find and check actions, newest first (kept on the Pi: the last 100).
    Each has n (its number), kind, at, by, its results, and pictures (cameras with a picture:
    GET /api/vision/image?n=&cam=)."""
    return history.recent(max(1, min(limit, 100)))


@app.get("/api/vision/last")
def vision_last():
    """The last see, find or check (null before the first)."""
    return history.last()


@app.get("/api/vision/image")
def vision_image(n: int | None = None, cam: str = "1"):
    """The picture action n used (the last see or find when n is left out)."""
    rec = history.get(n) if n is not None else next((r for r in reversed(history.items) if cam in r.get("pictures", [])), None)
    jpg = rec and history.picture(rec["n"], cam)
    if not jpg:
        raise HTTPException(404, f"no picture from cam {cam}" + (f" for action {n}" if n is not None else ""))
    return Response(jpg, media_type="image/jpeg", headers={"Cache-Control": "max-age=86400" if n is not None else "no-store"})


@app.get("/api/stream")
async def stream(cam: int = 0, fps: float = 10):
    """Live MJPEG view of one camera, 820 px wide. Open it in a browser tab or an <img>."""
    c = get_camera(cam)

    async def frames():
        while True:
            jpg = await asyncio.to_thread(c.frame)
            if jpg is None:
                return
            yield b"--frame\r\nContent-Type: image/jpeg\r\nContent-Length: %d\r\n\r\n" % len(jpg) + jpg + b"\r\n"
            await asyncio.sleep(1 / max(fps, 0.5))

    return StreamingResponse(frames(), media_type="multipart/x-mixed-replace; boundary=frame",
                             headers={"Cache-Control": "no-store"})


class Calibrate(BaseModel):
    room: float | None = None   # how far the cup is above the board at the start (mm); left out: the
                                # current Z, once the board has been touched off (Z is then the cup's height)
    span: float = 60    # grid half-width, mm, around where the head is now (a 120 mm square)
    steps: int = 3      # steps x steps stops per height
    levels: int = 3     # heights, from the start down to 15 mm above the board
    feed: float = 2000  # mm/min for going down a level; moves within a level are rapid
    from_zero: bool = False   # the cup touches the board at Work zero X, Y, Z = 0 (see vision.calibrate)


@app.post("/api/calibrate")
async def calibrate(body: Calibrate):
    """Move the head marker over a grid at several heights and fit every camera. Takes ~2-3 min.
    Start with Z at its top (that becomes the travel height) over the middle of the board, Esper
    out from under the square; it goes down from there, never closer than 15 mm to the board."""
    if body.from_zero:
        return await asyncio.to_thread(vision.calibrate, 0.0, body.span, body.steps, body.levels, body.feed, from_zero=True)
    room = body.room
    if room is None:
        if (vision.cal or {}).get("table_source") != "touch":
            return {"ok": False, "error": "say how far the cup is above the board (room): the board hasn't been touched off"}
        room = (grbl.status.get("WPos") or [0, 0, 0])[2]
    return await asyncio.to_thread(vision.calibrate, room, body.span, body.steps, body.levels, body.feed)


@app.post("/api/calibrate/stop")
def calibrate_stop():
    """Stop a running calibration: the move under way finishes (a second or two), then no
    more. GRBL keeps its position, so there's nothing to re-anchor (unlike STOP, which resets)."""
    vision.stop()
    return {"ok": True, "running": vision.busy}


@app.get("/api/calibration")
def calibration():
    """Is it calibrated, how well, and does it still agree with the gantry."""
    return vision.summary()


@app.post("/api/calibration/table")
async def calibration_table():
    """The cup is touching the board right now: Z becomes 0 there. Also the fix when Z has
    skipped steps (a lift that stalled)."""
    return await asyncio.to_thread(vision.set_table)


class Travel(BaseModel):
    z: float | None = None   # cup height (work Z) that's safe over Esper; None = the current Z


@app.post("/api/calibration/travel")
def calibration_travel(body: Travel = Travel()):
    """Set the travel height: the cup height that's safe over Esper (110 mm clears it)."""
    return vision.set_travel(body.z)


@app.post("/api/calibration/bounds")
async def calibration_bounds():
    """Measure the board markers and save the cup's allowed X/Y: inside their inner edges."""
    return await asyncio.to_thread(vision.set_bounds)


@app.post("/api/calibration/reanchor")
async def reanchor(camera: bool = False):
    """After a GRBL reset: put the work coordinates back to the saved position (exact if nothing
    moved). ?camera=true takes X/Y from the camera instead, for when the head really moved."""
    return await asyncio.to_thread(vision.reanchor, camera)


@app.post("/api/calibration/trust")
async def trust():
    """After a GRBL reset: take GRBL's current work position as right and lift the hold on moves,
    without changing any coordinates. For a person at the jog page; not an agent tool."""
    vision.needs_reanchor = False
    return {"ok": True}


@app.get("/api/scene")
async def scene(fresh: bool = False):
    """Where everything is, in gantry coordinates: head, Esper, cards (face-up ones named: card,
    from the card cache), chip stacks (chips: [{x, y, height_mm, count, count_raw, colour, fit}]; count_raw unrounded, 7.4 is a shaky 7; from cam 1's
    colours, where they really stand), decks ([{x, y, angle, height_mm, cards, fit}], likewise),
    board markers, cameras."""
    return await asyncio.to_thread(vision.update) if fresh else vision.scene


# ---- Esper: driving with the camera ----

def esper_pose(n=3):
    """Esper's marker pose (x, y, heading), averaged over a few fresh looks; None if unseen."""
    seen = []
    for _ in range(n):
        m = vision.update().get("esper")
        if m and not m.get("assumed"):
            seen.append((m["x"], m["y"], m["heading"]))
        time.sleep(0.15)
    if not seen:
        return None
    h0 = seen[0][2]
    hs = [h0 + ((h - h0 + 180) % 360 - 180) for _, _, h in seen]
    p = (sum(p[0] for p in seen) / len(seen), sum(p[1] for p in seen) / len(seen), sum(hs) / len(hs))
    esper.seen(p)
    return p


def esper_home():
    """Esper's home: saved in the calibration, or by default the middle of the left margin,
    halfway between the left board markers, facing into the board (+X)."""
    if vision.cal and vision.cal.get("esper_home"):
        return vision.cal["esper_home"]
    board = vision.update().get("board") or {}
    pts = [(b["x"], b["y"]) for b in board.values()]
    if len(pts) < 2:
        return None
    mid = sum(x for x, _ in pts) / len(pts)
    left = [(x, y) for x, y in pts if x < mid]
    if len(left) < 2:
        return None
    return [round(sum(x for x, _ in left) / len(left), 1), round(sum(y for _, y in left) / len(left), 1), 0.0]


class EsperGoto(BaseModel):
    x: float
    y: float
    heading: float | None = None   # degrees, anticlockwise from +X; None = any
    check: bool = True             # cam 1 checks the way first (~1 s, no API call); false = just go


ESPER_EYE = ESPER_SIZE[0] / 2 - ESPER_CENTRE[0]   # the camera, on the front face, ahead of the turning centre (mm)
MAT_GREY = 120          # cam 1: the mat is darker than this (it reads 30-85 across the board)
MAT_RED = (100, 90)     # ...and anything this saturated and bright isn't the mat either (a red chip)
IN_THE_WAY_PX = 120     # px: something this big in cam 1 is in the way (a chip is ~2000)
MARKER_CLEAR = 30       # mm around a board marker's centre that's the marker, not in the way
ESPER_BODY = (-67.0, 87.0, -67.0, 67.0)   # Esper's footprint from its marker (back, front with the flipper down, right, left), mm
ESPER_GAP = 3.0          # mm: how close Esper may pass something
ESPER_SELF = 25.0        # mm around Esper's box that's still Esper in the picture (its arm and wheels)
CARD_MM = ((52, 76), (78, 100))   # a lying card's footprint as cam 1 maps it (63 x 88; fine for Esper to drive over)


def _footprint(cx, cy, heading, grow=ESPER_GAP):
    """Esper's footprint on the board with its turning centre at (cx, cy): 4 corners."""
    b, f, r, l = ESPER_BODY
    a = math.radians(heading)
    c, s = math.cos(a), math.sin(a)
    return [(cx + c * (u - ESPER_CENTRE[0]) - s * (v - ESPER_CENTRE[1]), cy + s * (u - ESPER_CENTRE[0]) + c * (v - ESPER_CENTRE[1]))
            for u, v in ((b - grow, r - grow), (f + grow, r - grow), (f + grow, l + grow), (b - grow, l + grow))]


def _sweep(start, h0, end, h1, h2):
    """Where Esper's footprint goes: turning at start from h0 to h1, driving to end, turning to
    h2 (h2 None: no turn). Convex pieces (lists of x, y)."""
    turn = lambda c, a, b: [_footprint(*c, a + (b - a) * k / 12) for k in range(13)]
    d = lambda a, b: (b - a + 180) % 360 - 180
    out = turn(start, h0, h0 + d(h0, h1))
    out.append(_footprint(*start, h1) + _footprint(*end, h1))        # its hull is the drive
    if h2 is not None:
        out += turn(end, h1, h1 + d(h1, h2))
    return out


def _in_the_way(pose, end, heading=None, ignore=()):
    """What Esper would touch driving from `pose` (its marker's x, y, heading) to `end` (its
    turning centre) and turning to `heading`, the way esper.goto drives (turn toward it, or
    away and back up, then drive), from a fresh cam 1 picture: anything that isn't dark mat
    where its footprint goes (ESPER_GAP to spare), apart from Esper itself, the gantry head, the
    board markers and the spots in `ignore`. Only on the mat (inside the board markers): past
    them is the table. [{x, y, px}], or why it can't tell (a string)."""
    P, _ = vision._cam(1)
    tz = (vision.cal or {}).get("table_z")
    marks = (vision.scene or {}).get("board") or {}
    if P is None or tz is None:
        return "cam 1 isn't calibrated"
    if len(marks) < 4:
        return "cam 1 can't see all four board markers"
    jpg = get_camera(1).capture()
    if jpg is None:
        return "cam 1 gave no picture"
    img = cv2.imdecode(np.frombuffer(jpg, np.uint8), cv2.IMREAD_COLOR)
    shape = img.shape[:2]
    pix = lambda pts, z=tz: np.array([eyes.project(P, (x, y, z)) for x, y in pts], np.int32)
    start = esper.centre(pose)
    h1 = math.degrees(math.atan2(end[1] - start[1], end[0] - start[0]))
    if abs((h1 - pose[2] + 180) % 360 - 180) > 90:      # it backs up there instead
        h1 += 180
    if math.hypot(end[0] - start[0], end[1] - start[1]) <= ESPER_CLOSE:
        h1 = pose[2]                                     # already there: only the last turn
    path = np.zeros(shape, np.uint8)
    for piece in _sweep(start, pose[2], end, h1, heading):
        cv2.fillConvexPoly(path, cv2.convexHull(pix(piece)), 1)
    mat = np.zeros(shape, np.uint8)
    cv2.fillConvexPoly(mat, cv2.convexHull(pix([(m["x"], m["y"]) for m in marks.values()])), 1)
    path &= mat
    me = _footprint(*start, pose[2], ESPER_SELF)          # Esper itself, from below the board to its top
    cv2.fillConvexPoly(path, cv2.convexHull(np.r_[pix(me, tz - 20), pix(me, tz + ESPER_SIZE[2])]), 0)
    for name, r in eyes.robot_masks(P, _robot_boxes() or {}, shape).items():
        if name != "esper":
            path[r > 0] = 0
    ring = lambda c, r: [(c[0] + r * math.cos(t), c[1] + r * math.sin(t)) for t in np.linspace(0, 2 * math.pi, 32)]
    for c in [(m["x"], m["y"]) for m in marks.values()]:
        cv2.fillConvexPoly(path, pix(ring(c, MARKER_CLEAR)), 0)
    for c in ignore:
        cv2.fillConvexPoly(path, pix(ring(c, 35)), 0)
    hsv = cv2.cvtColor(img, cv2.COLOR_BGR2HSV)
    odd = (cv2.cvtColor(img, cv2.COLOR_BGR2GRAY) > MAT_GREY) | ((hsv[..., 1] > MAT_RED[0]) & (hsv[..., 2] > MAT_RED[1]))
    odd = cv2.morphologyEx((odd & (mat > 0)).astype(np.uint8), cv2.MORPH_OPEN, np.ones((3, 3), np.uint8))
    k, labels = cv2.connectedComponents(odd)
    hit = []
    for i in range(1, k):
        thing = labels == i
        inside = thing & (path > 0)
        n = int(inside.sum())
        if n < IN_THE_WAY_PX or _a_card(P, thing, tz):
            continue                                     # Esper drives over cards (it's 3 mm up)
        ys, xs = np.nonzero(inside)
        x, y = to_xy(P, np.array([[xs.mean(), ys.mean()]]), tz)[0]
        hit.append({"x": round(float(x), 1), "y": round(float(y), 1), "px": n})
    return hit


def _a_card(P, thing, tz):
    """Is this blob (a 0/1 picture) one playing card lying on the board: its footprint about
    63 x 88 mm and filling its rectangle?"""
    cs, _ = cv2.findContours(thing.astype(np.uint8), cv2.RETR_EXTERNAL, cv2.CHAIN_APPROX_SIMPLE)
    if not cs:
        return False
    q = to_xy(P, max(cs, key=cv2.contourArea).reshape(-1, 2).astype(float), tz).astype(np.float32)
    (_, _), (w, h), _ = cv2.minAreaRect(q)
    w, h = sorted((w, h))
    return CARD_MM[0][0] <= w <= CARD_MM[0][1] and CARD_MM[1][0] <= h <= CARD_MM[1][1] \
        and cv2.contourArea(q) > 0.8 * w * h


def esper_goto(x, y, heading, check=True, ignore=()):
    if not vision.cal:
        return {"ok": False, "error": "not calibrated"}
    b = vision.cal.get("bounds")
    if b and not (b[0] - 80 <= x <= b[1] + 80 and b[2] - 80 <= y <= b[3] + 80):
        return {"ok": False, "error": "that's off the board"}
    if vision.needs_reanchor:                           # can't tell how high the head is
        return {"ok": False, "error": UNANCHORED["reply"].removeprefix("error:")}
    travel = vision.cal.get("travel_z")
    if travel is not None and z_now() < travel - 0.5:   # nothing low for Esper to run into
        if grbl.send(f"G90 G0 Z{travel:.3f}") != "ok" or grbl.send("G4 P0", 60) != "ok":
            return {"ok": False, "error": "couldn't raise the head first"}
    p = esper_pose() or esper.pose                         # unseen: where it was last seen, plus moves since
    if p is None:
        return {"ok": False, "error": "the camera can't see Esper's marker, and hasn't since the hub started"}
    if check:
        hit = _in_the_way(p, (x, y), heading, ignore)
        if isinstance(hit, str):
            return {"ok": False, "error": f"can't check Esper's way: {hit} (check=false to go anyway)"}
        if hit:
            return {"ok": False, "error": "something is in Esper's way", "in_the_way": hit}
    res = esper.goto(esper_pose, x, y, heading)
    res["checked_path"] = check
    return res


@app.post("/api/esper/goto")
async def esper_goto_api(body: EsperGoto):
    """Drive Esper so its turning centre ends on (x, y), then turn to `heading`. Turns, drives,
    looks with the camera and corrects until within ~5 mm and ~3 deg. Raises the gantry head to
    travel height first. With check (the default), cam 1 looks at the way first (its lane and
    where it turns, ~1 s, no API call): anything on the mat there, or no way to check, and it
    refuses (in_the_way [{x, y}]). check=false just goes (a short hop in the clear, or pushing
    chips on purpose)."""
    return await asyncio.to_thread(esper_goto, body.x, body.y, body.heading, body.check)


class EsperMove(BaseModel):
    servo: float | None = None         # flipper angle, degrees (20 = rest, lying on the table)
    servo_speed: float | None = None   # required with servo: gentle (the peek lifts at 30); capped at 360
    turn: float | None = None          # degrees anticlockwise, in place
    drive: float | None = None         # mm, + forward
    wheel_speed: float = 500           # half-steps/s: 500 is the reliable top (Nov 4), the peek creeps at 200


@app.post("/api/esper/move")
async def esper_move_api(body: EsperMove):
    """One step of a recipe (the flip, the peek: agent/esper.md): the flipper to an angle at a
    gentle speed, starting at once and running while the wheels turn and then drive. Returns
    when both are done. Counted into where the hub thinks Esper is (its own /step isn't); no camera
    check of the way: drive only where you've looked (up to 200 mm a call)."""
    if body.servo is not None:
        if body.servo_speed is None:
            raise HTTPException(400, "give servo_speed with servo: fast flipper moves brown Esper out")
        if not 20 <= body.servo <= 150:
            raise HTTPException(400, "servo is 20 (rest) to 150 degrees")
    if body.drive is not None and abs(body.drive) > 200:
        raise HTTPException(400, "drive at most 200 mm a call")
    if body.turn is not None and abs(body.turn) > 360:
        raise HTTPException(400, "turn at most 360 degrees a call")
    if not 50 <= body.wheel_speed <= 500:
        raise HTTPException(400, "wheel_speed is 50 to 500 (faster is unreliable)")
    return await asyncio.to_thread(esper.move, body.servo, body.servo_speed, body.turn, body.drive,
                                   round(body.wheel_speed))


class EsperLook(BaseModel):
    x: float
    y: float
    distance: float = 150.0          # from Esper's camera to (x, y), mm
    side: float | None = None        # look from this direction (degrees from +X, from the spot toward Esper); None = from where Esper is
    check: bool = True               # cam 1 checks the way first; false = just go


def esper_look(x, y, distance=150.0, side=None, check=True):
    p = esper_pose() or esper.pose
    if p is None:
        return {"ok": False, "error": "the camera can't see Esper's marker, and hasn't since the hub started"}
    cx, cy = esper.centre(p)
    a = math.radians(side) if side is not None else math.atan2(cy - y, cx - x)
    back = distance + ESPER_EYE
    spot = (x + back * math.cos(a), y + back * math.sin(a))
    heading = (math.degrees(a) + 180 + 180) % 360 - 180      # facing the spot
    res = esper_goto(spot[0], spot[1], heading, check, ignore=[(x, y)])
    res["looking_at"] = [x, y]
    return res


@app.post("/api/esper/look")
async def esper_look_api(body: EsperLook):
    """Send Esper to look at a spot on the board with its own camera: it drives (with the
    overhead camera checking) to `distance` mm from (x, y) and faces it, from `side` or from
    where it already is. Then use cam=esper with /api/see (ask=...) or /api/find to look. Like
    goto, it checks the way first (in_the_way; check=false skips that). ~20 s."""
    return await asyncio.to_thread(esper_look, body.x, body.y, body.distance, body.side, body.check)


@app.get("/api/esper/home")
def esper_home_get():
    return {"home": esper_home()}


@app.post("/api/esper/home")
async def esper_home_go():
    """Send Esper home (see GET /api/esper/home)."""
    h = esper_home()
    if not h:
        return {"ok": False, "error": "no home yet: the camera needs the left board markers"}
    return await asyncio.to_thread(esper_goto, *h)


class EsperHome(BaseModel):
    x: float | None = None          # all None = where Esper is now
    y: float | None = None
    heading: float | None = None


@app.post("/api/esper/home/set")
async def esper_home_set(body: EsperHome):
    """Save Esper's home: a spot and heading, or (no body) where Esper is now."""
    if body.x is None or body.y is None:
        p = await asyncio.to_thread(esper_pose)
        if p is None:
            return {"ok": False, "error": "the camera can't see Esper"}
        cx, cy = esper.centre(p)
        home = [round(cx, 1), round(cy, 1), round(p[2], 1)]
    else:
        home = [body.x, body.y, body.heading if body.heading is not None else 0.0]
    vision.cal["esper_home"] = home
    vision.save()
    return {"ok": True, "home": home}


FACES = HERE / "faces"     # software/esper/faces, deployed next to the hub (eyes.bin, reactions/)


def esper_face(name="eyes", loop=True):
    """Put a face on Esper's screen at once, in the background; loop=True holds it until the
    next face. "eyes" is Esper's normal look. Never raises: a face is nice, not needed."""
    if not esper:
        return
    path = FACES / "eyes.bin" if name == "eyes" else FACES / "reactions" / f"{name}.bin"
    def go():
        try:
            esper.screen(path.read_bytes(), 12 if name == "eyes" else 10, 0 if (loop or name == "eyes") else 1)
        except (OSError, ValueError):
            pass
    threading.Thread(target=go, daemon=True).start()


class EsperFace(BaseModel):
    name: str = "eyes"   # a reaction face (GET /api/esper/gestures lists the faces in use), or "eyes"
    loop: bool = True    # true: keep replaying it until the next face (no drop back to the eyes); false: play once


@app.post("/api/esper/face")
def esper_face_api(body: EsperFace):
    """Just a face on Esper's screen, now, with no move and no chat line: set it BEFORE anything
    slow (a Muse call, a find, a peek) so Esper looks busy instead of frozen. "eyes" goes back to
    normal. Gestures still end on the eyes."""
    if body.name != "eyes" and not (FACES / "reactions" / f"{body.name}.bin").exists():
        raise HTTPException(400, f"no face {body.name!r}; have {sorted(p.stem for p in (FACES / 'reactions').glob('*.bin'))}")
    esper_face(body.name, body.loop)
    return {"ok": True}


def gestures():
    return {k: v for k, v in json.loads((GUIDES / "gestures.json").read_text()).items() if not k.startswith("_")}


@app.get("/api/esper/gestures")
def esper_gestures():
    """Esper's gestures by name: what each says in the chat and which face it shows."""
    return {k: {"emoji": g.get("emoji", ""), "text": g["text"], "face": g.get("face")} for k, g in gestures().items()}


class Gesture(BaseModel):
    name: str | None = None          # one of GET /api/esper/gestures
    to: str | None = None            # who it's aimed at (a player's name), for the chat line
    wait: bool = False               # True: return once it's done
    # or a one-off gesture of your own instead of a name (same fields as agent/gestures.json):
    emoji: str = ""
    text: str | None = None
    face: str | None = None
    steps: list[dict] = []


@app.post("/api/esper/gesture")
async def esper_gesture(body: Gesture):
    """Esper reacts: a face, flipper and wheel moves, ending where it started (a few cm at most).
    The gesture goes in the chat as Esper's: Esper never speaks, this is how it talks. Returns at
    once unless wait=true; Esper refuses while it's busy (a goto or another gesture)."""
    if body.name:
        g = gestures().get(body.name)
        if g is None:
            raise HTTPException(404, f"no gesture {body.name!r}; see GET /api/esper/gestures")
    elif body.text:
        g = {"emoji": body.emoji, "text": body.text, "face": body.face, "steps": body.steps}
    else:
        raise HTTPException(400, "give a gesture name, or text (+ face, steps) for a one-off")
    if g.get("face") and not (FACES / "reactions" / f"{g['face']}.bin").exists():
        raise HTTPException(400, f"no face {g['face']!r}; have {sorted(p.stem for p in (FACES / 'reactions').glob('*.bin'))}")
    if esper.busy:
        return {"ok": False, "error": "Esper is busy"}
    said = (g["to"].format(to=body.to) if "to" in g else f"{g['text']} at {body.to}") if body.to else g["text"]
    item = chat.add(f"{g.get('emoji', '')} {said}".strip(), "esper", "gesture", gesture=body.name or "custom",
                    **({"to": body.to} if body.to else {}))
    run = asyncio.to_thread(esper.gesture, g, FACES)
    if body.wait:
        return {**await run, "chat": item}
    asyncio.create_task(run)
    return {"ok": True, "chat": item}


class Say(BaseModel):
    text: str
    by: str = "agent"    # who's speaking: the agent's own name ("Muse", "Claude")
    wait: bool = False   # True: return once it has been spoken


@app.post("/api/say")
async def say(body: Say):
    """Speak out loud on the table's speaker, and the line goes in the chat under `by`. Use it to
    talk to the people at the table, and to ask them when something is impossible or unclear;
    their answers come back in the chat (GET /api/chat?after=<id>&wait=30)."""
    if body.by in ("player", "esper"):
        raise HTTPException(400, "players type or talk on the talk page; Esper never speaks (use /api/esper/gesture)")
    chat.add(body.text, body.by[:32], "speaker")
    err = await asyncio.to_thread(voice.say, body.text, body.wait)
    return {"ok": err is None, "error": err}


@app.get("/api/voice")
def voice_get():
    """The table's voice: which Piper voice and pace, and the voices installed."""
    return {**voice.choice, "voices": voice.voices(), "speakers": list(voice.speakers(voice.choice["voice"])),
            "engine": "piper" if voice.voices() else "espeak-ng"}


class VoiceChoice(BaseModel):
    voice: str | None = None        # one of GET /api/voice -> voices
    pace: float | None = None       # 1 = normal, 0.8 = a bit faster, 1.2 slower
    speaker: str | None = None      # in a multi-speaker voice: a name (e.g. "prudence") or number


@app.post("/api/voice")
def voice_set(body: VoiceChoice):
    err = voice.choose(body.voice, body.pace, body.speaker)
    return {"ok": err is None, "error": err, **voice.choice}


@app.post("/api/transcribe")
async def transcribe(request: Request):
    """Body: one utterance as a 16 or 24 kHz mono 16-bit WAV. Returns the transcript item,
    or {"text": ""} if nothing was said."""
    wav = await request.body()
    if len(wav) < 1000:
        raise HTTPException(400, "no audio")
    try:
        item = await asyncio.to_thread(chat.transcribe, wav)
    except TranscribeError as e:
        raise HTTPException(502, str(e))
    except Exception as e:  # network trouble reaching Meta
        raise HTTPException(502, f"couldn't reach Meta: {e}")
    return item or {"text": ""}


@app.get("/api/chat")
async def get_chat(after: int = 0, wait: float = 0, by: str | None = None):
    """The table's chat, oldest first: what people said (voice) or typed, what the agent said
    out loud (via "speaker", by = its name), and Esper's gestures (by "esper", via "gesture").
    after=<id>: only newer messages. wait=N: if there are none yet, wait up to N seconds
    (max 60) for one, so an agent can loop on this to follow the conversation. by=player: only
    people's messages."""
    deadline = time.monotonic() + min(max(wait, 0), 60)
    while True:
        items = [i for i in chat.since(after) if by is None or i["by"] == by]
        if items or time.monotonic() >= deadline:
            return items
        await asyncio.sleep(0.2)


class ChatPost(BaseModel):
    text: str
    by: str = "player"      # "player" from the talk page; an agent may post as itself


@app.post("/api/chat")
def post_chat(body: ChatPost):
    """Add a typed message to the chat (not spoken; for spoken lines use /api/say)."""
    if body.by == "esper":
        raise HTTPException(400, "Esper talks with gestures: /api/esper/gesture")
    item = chat.add(body.text[:2000], body.by[:32], "typed")
    if not item:
        raise HTTPException(400, "empty message")
    return item


@app.delete("/api/chat")
def clear_chat():
    """Start a fresh chat. The old one is kept on the Pi in chats/chat-<date>-<time>.jsonl;
    message ids keep counting up, so an agent waiting on the chat isn't thrown off."""
    return {"cleared": True, "archived": chat.clear()}


@app.get("/api/transcripts")
def get_transcripts(since: int = 0):
    """Old name: the chat (see /api/chat)."""
    return chat.since(since)


@app.websocket("/ws/listen")
async def listen(ws: WebSocket):
    """Live speech to text for one utterance. The page sends 16 kHz mono PCM16 as binary frames
    while the person talks, then the text "end". It gets {"type": "partial", text} as words are
    recognised, then {"type": "final", item} (item is the chat message, or null if nothing was
    said) or {"type": "error", error}. Every page also gets `chat_partial` events."""
    await ws.accept()
    deadline = time.monotonic() + 90             # one utterance; Meta allows far more

    async def audio():
        while time.monotonic() < deadline:
            m = await ws.receive()
            if m["type"] == "websocket.disconnect":
                return
            if m.get("bytes"):
                yield m["bytes"]
            elif m.get("text") == "end":
                return

    async def partial(text):
        await ws.send_json({"type": "partial", "text": text})
        broadcast({"type": "chat_partial", "text": text})

    try:
        item = await chat.stream(audio(), partial)
        await ws.send_json({"type": "final", "item": item})
    except TranscribeError as e:
        await ws.send_json({"type": "error", "error": str(e)})
    except WebSocketDisconnect:
        pass
    finally:
        broadcast({"type": "chat_partial", "text": None})
        with contextlib.suppress(Exception):
            await ws.close()


@app.websocket("/ws")
async def ws(ws: WebSocket):
    await ws.accept()
    clients.add(ws)
    await ws.send_json({"type": "settings", "settings": grbl.settings})
    await ws.send_json({"type": "status", **grbl.status, "homed": grbl.homed})
    await ws.send_json({"type": "gripper", **gripper.state})
    try:
        while True:
            await ws.receive_text()  # keepalive only; commands go over HTTP
    except WebSocketDisconnect:
        pass
    finally:
        clients.discard(ws)
        # a page that goes away mid-jog must not leave the gantry running
        if not clients and grbl.status.get("state") == "Jog":
            grbl.realtime("jog_cancel")


@app.get("/")
def home_page():
    """The home page: every page and tool on the table, in one list."""
    return FileResponse(HERE / "static" / "home.html", headers={"Cache-Control": "no-cache"})


@app.get("/jog")
def jog_page():
    return FileResponse(HERE / "static" / "jog.html", headers={"Cache-Control": "no-cache"})


GUIDES = HERE / "agent"   # the repo's agent/ folder, deployed next to the hub


@app.get("/api/guide", response_class=PlainTextResponse)
def guide():
    """Start here: what the table and Esper can do and how to behave (agent/README.md). The agent
    reads this first, then /api/guide/table, /api/guide/esper and /api/notes."""
    return (GUIDES / "README.md").read_text()


@app.get("/api/guide/{name}", response_class=PlainTextResponse)
def guide_page_text(name: str):
    path = GUIDES / f"{name}.md"
    if not name.isidentifier() or not path.exists():
        raise HTTPException(404, f"no guide {name}; try table, esper or poker")
    return path.read_text()


@app.get("/guide")
def guide_page():
    return FileResponse(HERE / "static" / "guide.html", headers={"Cache-Control": "no-cache"})


NOTES = HERE / "notes.md"   # this build's notes; lives on the Pi only (not deployed, not in git)


class Note(BaseModel):
    text: str
    by: str = "agent"


@app.get("/api/notes", response_class=PlainTextResponse)
def notes():
    """What agents and people have learned about this particular build. Read after the guide."""
    return NOTES.read_text() if NOTES.exists() else "# Notes on this build\n\n(none yet)\n"


@app.post("/api/notes")
def add_note(body: Note):
    """Add one dated note: something learned about this build that the next agent should know."""
    if not NOTES.exists():
        NOTES.write_text("# Notes on this build\n\nWhat agents and people learned about this particular table. "
                         "Newest at the bottom. Add with POST /api/notes {text, by}.\n\n")
    line = " ".join(body.text.split())
    with NOTES.open("a") as f:
        f.write(f"- {time.strftime('%Y-%m-%d %H:%M')} ({body.by}): {line}\n")
    return {"ok": True}


@app.get("/vision")
def vision_page():
    return FileResponse(HERE / "static" / "vision.html", headers={"Cache-Control": "no-cache"})


@app.get("/eyes")
def eyes_page():
    return RedirectResponse("/vision")   # the old name


@app.get("/scene")
def scene_page():
    return FileResponse(HERE / "static" / "scene.html", headers={"Cache-Control": "no-cache"})


@app.get("/talk")
def talk():
    return FileResponse(HERE / "static" / "talk.html", headers={"Cache-Control": "no-cache"})


app.mount("/static", StaticFiles(directory=HERE / "static"), name="static")
