ahamal/magic-table/(commit log)

2026-10-28 Switch Mate to ESP32; add wheels and Nano firmware
    Mate drops the Pi 3 + Arduino for an ESP32 (DevKit now, Freenove
    ESP32-S3 CAM next) that serves its API over Wi-Fi. Docs updated for
    the new parts, pins, perfboard hub, power and size estimate; the Pi 3
    server is retired.
    Also adds the 60 mm printed wheels (0.5 mm shaft clearance, fit test)
    and the tested Arduino Nano firmware, which will be ported to the ESP32.
    [fit-test.stl, wheel.stl]
2026-10-28 Add printed plywood corner joints for Mate chassis
    corner.py generates slot-joined corners for 4 mm ply (4.4 mm slots,
    15 mm deep, rounded outside, thicker inside walls) in normal and thick
    versions, plus a slot fit test. README has fit, cut list and printing.
    [corner-normal-v3.stl, corner-thick-v3.stl, slot-test.stl]
2026-10-28 Add ESP32 bring-up test: I2C, web server and steppers
    Bench firmware for the ESP32 Mate: VL6180X, OLED and PCA9685 over I2C,
    a web control page and JSON API at mate.local, and both steppers on
    their own core. Wi-Fi credentials live in a git-ignored secrets.h.
2026-10-28 Remove Nano firmware; Mate runs on the ESP32 now
    The firmware README now points to the ESP32 bench test in
    software/mate/tests until the real firmware is written.
2026-10-30 Add build log; update Frame docs for CNC Shield and new gripper
    The Frame runs GRBL 1.1h with CoreXY on an Uno + CNC Shield, not RAMPS.
    The gripper is now a 12V diaphragm pump plus a normally-closed vent
    valve, switched by a Nano so the Pi 5 never touches 12V. Records the
    tuned GRBL speed and acceleration, the Pi hostname, and a dated log of
    what happened so far.
    [wheel.stl]
2026-10-30 Enlarge Mate wheel to 70 mm
    Replaces the 60 mm wheel.stl with wheel-70.stl for a little more speed
    on the 28BYJ-48 (about 4.3 cm/s at 800 half-steps/s). Same 0.5 mm bore
    clearance; tire groove and O-ring size updated to match.
    [wheel-70.stl]
2026-10-30 Add hub server and Frame jog page
    FastAPI on the Pi 5 keeps one serial connection to GRBL open, sends
    lines one at a time, polls status and pushes it to pages over a
    WebSocket. The jog page builds on the Robo Diner one (click a target on
    the XY table and Z rail) and adds live position, tap and hold-to-jog
    with keyboard control, zeroing, STOP and a console. Runs as a systemd
    service so it starts on boot.
2026-10-30 Redesign jog page as one flat screen
    Table map fills the left, controls sit in one right-hand column with
    thin dividers instead of nested cards. Square, compact, segmented
    buttons; position readout and STOP in the top bar.
2026-10-31 Move Mate to the ESP32-S3 CAM with camera capture and stream
    New firmware for the Freenove ESP32-S3-WROOM CAM: wheels, servos straight
    from the ESP32's PWM, OLED, and the bundled GC0308 camera as a JPEG
    snapshot (/capture) and MJPEG stream (:81/stream). The PCA9685 and the
    VL6180X edge sensor are dropped. The camera clock only runs while a
    picture is being taken, since a running camera jams the board's Wi-Fi.
    [firmware.ino]
2026-10-31 Regroup Mate pins, add bitmap screen, rotate camera
    Each wheel is now one 4-pin row on the right header (1,2,42,41 and
    45,48,47,21), with the OLED on 20/19. Pan and tilt servos are gone;
    the flipper is the only servo. /screen takes raw 128x64 bitmaps, up to
    64 frames looped at X-FPS, with a status screen as the default, and
    the control page has a drawable screen with text rendering. The camera
    is rotated 180 degrees in software, since the GC0308 driver ignores
    vflip.
    [firmware.ino]
2026-10-31 Keep Mate up on the power bank when the servo moves
    The MG996R sagged the bank's 5V enough to trip the ESP32-S3's brownout
    reset. The firmware now turns that reset off and lowers Wi-Fi transmit
    power, and /status reports the last restart reason and a restart count.
    [firmware.ino]
2026-10-31 Add ready-made faces for Mate's screen
    software/mate/faces/ draws screen animations in code (make.py) and keeps
    the ready-to-send frames and previews: blinking, glancing eyes, a pecking
    chicken, and a cartoon portrait drawn from Mate's camera.
2026-10-31 Write Mate's API reference; add play-N-times to /screen
    software/mate/README.md now documents every endpoint for the AI brain:
    parameters, ranges, defaults, reply fields, real replies and every
    error, plus driving directions and a typical agent loop.
    /screen takes an X-Repeat header (0 loops forever, N plays N times then
    holds the last frame) and /status reports screen.done. /info keys are
    now max_steps, max_speed and max_accel, matching the rest.
    [firmware.ino]
2026-10-31 Let /servo sweep at a chosen speed
    /servo takes an optional speed in degrees/s, and Mate sweeps the flipper
    there in small steps. /status reports where it is now and whether it's
    still moving. Without a speed it still jumps. The control page has a
    flipper speed slider.
    [firmware.ino]
2026-10-31 Give the flipper a 20° resting pose that survives power-off
    Mate saves the flipper angle to flash once it has settled with the
    wheels still. At boot it starts at the saved angle, so the arm doesn't
    jump, then sweeps to the 20° resting pose while Wi-Fi connects.
    [firmware.ino]
2026-10-31 Add the gripper server and Nano firmware
    The Nano switches the 12V pump and vent valve through low-side MOSFETs
    (D2 pump, D3 valve). A FastAPI service on the Pi (port 8001) keeps the
    serial port open and serves a page with pump/valve switches and
    Grip/Drop/STOP. It runs as gripper.service, separate from the GRBL hub.
2026-10-31 Drive the gripper from GRBL and add the overhead camera to the hub
    The Nano's USB cable plus its ground to 12V − made a ground loop through
    the Pi that knocked the Uno off USB on every move. The pump now runs from
    the CNC Shield's CoolEn pin (M8/M9) and the vent valve from SpnDir
    (M4 S0 / M3 S0), and the hub on port 8000 serves grip, drop and the
    switches. The port-8001 gripper service is retired.
    The Camera v2 now works on the Pi 5; the hub keeps it open and serves
    GET /api/capture.
2026-11-01 Serve both cameras from the hub; add ArUco markers and head plate
    The hub opens every camera the Pi finds (ov5647 and Camera v2) and serves
    /api/cameras, /api/capture?cam= and a live MJPEG /api/stream?cam=; the
    jog page shows both live views. An open stream no longer stalls hub
    restarts (TimeoutStopSec).
    hardware/frame/markers: a printable sheet of ArUco markers for the board
    corners and the head, and an M5 plate that holds the head marker on a
    20x20 extrusion, for camera calibration.
    [marker-mount.stl]
2026-11-01 Add vision, 3D scene, talk page and safe calibration to the hub
    Vision (vision.py, no cloud AI): OpenCV calibrates each camera against the
    gantry with the head marker at three heights, then finds the head, Mate,
    cards and board markers in gantry coordinates twice a second. A 3D page
    at /scene shows them live. Calibration starts at the top of Z and only
    goes down, to 15 mm above the board, and aborts with no further moves on
    any reset, pause, alarm or STOP. Below travel height the hub keeps the
    head off Mate.
    Talk page (/talk on HTTPS :8443): phones record instructions and Meta's
    Muse Voice Transcribe turns them into text. serve.py runs HTTP and HTTPS
    in one process.
    GRBL: Z inverted ($3=4)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
    [marker-mount.stl]
2026-11-01 Add the cup offset, tip moves, real head and Mate models, safer Mate rule
    The cup sits in front of the Z extrusion, not under the head marker, so
    every move landed ~25 mm short. vision.TIP_OFFSET (measured by camera)
    and POST /api/tip put the cup itself on a target; a card center far from
    the calibration grid now comes out within ~2-3 mm.
    Mate rule: sideways bumps are fine, pressing down isn't. Travel height is
    110 (Mate is 105 over its caps); the hub refuses to lower or end the cup
    over Mate below it, using the cup's position. Re-anchor restores the saved
    position exactly after a plain restart, even when no camera sees the head.
    3D page: head and Mate built from measurements (wheels, prou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
    [server.py, vision.py]
2026-11-01 Add the table guide and build notes; general timed grip
    GUIDE.md (served at /guide and /api/guide): coordinates, limits, the
    gripper, and pick-and-place recipes, tuned on the real table: 1 s pump,
    peel at F1500 (F2000 left cards behind), lift to Z 40, place at F1200,
    ~7.5 s per card. Six cards stacked into one pile with it.
    Build notes (GET/POST /api/notes) live on the Pi in ~/hub/notes.md, not
    in git: what agents learn about this particular table.
    grip keeps the pump on; grip?pump_s=N pumps N s and then holds on the
    vacuum (~20 s). Recipes like that live in the guide, not the code.
    Re-anchor now restores the saved position by default; the camera was
    20-33 mm off at the edge of the calibra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
2026-11-01 Add board bounds, center the origin, show camera modules in 3D
    The cup now stays inside the rectangle between the board markers' inner
    edges (measured by camera, POST /api/calibration/bounds): moves outside
    are refused, X/Y jogs stop at the edge. Setting the bounds also moves
    X/Y 0, 0 to their center, as a pure shift of GRBL's work coordinates and
    the camera models.
    The automatic camera-bump correction is off: with markers that had moved
    since calibration it warped the whole scene. It only warns now.
    3D page: each camera module drawn where calibration puts it, aimed the
    way it looks, with its picture's footprint on the board; the bounds as a
    dashed line; the cup at its real 15 mm.
    Co-Auth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
    [server.py, vision.py]
2026-11-01 Add agent docs, the hub's voice, Mate status; draw the flipper
    agent/: one place for agents to start. README (what's available and how
    to behave: ask the humans out loud, Mate as the friendly communicator,
    safety then speed, look-act-check, keep notes), table.md (the gantry
    guide, moved from the hub), mate.md (driving, calibrating, flipper
    gestures, faces, camera, helping turn cards). Served at /api/guide,
    /api/guide/{table,mate} and /guide.
    POST /api/say speaks on the table's Bluetooth speaker (espeak-ng; the
    service now has the user's audio session). The hub polls Mate's /status
    so the scene and the 3D page show the flipper's live angle.
    3D: Mate's flipper (a bent knife sweeping across i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
    [mate.py, server.py, vision.py, voice.py]
2026-11-02 Add a home page, faster calibration, and Mate's flipper on the right
    Home page at / lists every page (jog, 3D scene, talk, guides, notes,
    Mate's control page, camera streams, API docs) with a live status line;
    the jog page moved to /jog.
    Calibration takes ~40 s instead of ~2.5 min: rapid moves within a level,
    a shorter settle, and it keeps the board touch-off and bounds (both are
    in GRBL's coordinates, which recalibrating doesn't change).
    3D: the marker plate sits flush on the extrusion face, Mate's wheels are
    5 mm forward, and the flipper is on Mate's right side by the wheel.
    [server.py, vision.py]
2026-11-02 Fix the flipper's sweep in 3D; keep travel height across recalibration
    The flipper is pivoted by the right wheel near the front corner with the
    servo at 45 degrees, so it sweeps a diagonal plane around that corner
    onto the face (20 low across the front edge, 60 across the face, 110
    over the top). The 3D view and the Mate guide now say so.
    Recalibrating no longer resets the travel height to the start height.
    [vision.py]
2026-11-02 Turn cards on Mate and stack them; stop hub restarts resetting GRBL
    Six cards turned to the same angle on Mate's top and stacked, ~35 s each.
    The hub now lets the cup down to Mate's plywood top minus a gentle 1.5 mm
    squeeze (to place and pick a card there) and still crosses Mate at travel
    height. The recipe is in agent/mate.md: square Mate to the card first, put
    it on Mate's turning centre, turn, find it on Mate with cam 1, pick it with
    a 2 s pump.
    hub.service runs stty -hupcl before opening the port, so restarting the
    hub no longer resets the Uno: GRBL keeps its position and stays unlocked,
    and the hub only asks for a re-anchor after a real reset.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
    [grbl.py, server.py, vision.py]
2026-11-02 Give Mate a home and let the hub drive it there with the camera
    POST /api/mate/goto {x, y, heading} turns and drives Mate, looks with the
    overhead camera, and corrects until its turning centre is within ~5 mm
    and ~3 deg of the target (raising the gantry head first, refusing spots
    off the board). Mate's home is the middle of the left margin, in line with
    the left board markers, facing into the board: POST /api/mate/home goes
    there (first trip: one move, 16 s, 0.4 mm off), /api/mate/home/set saves
    a new one. The home survives recalibration and origin shifts, and the 3D
    page draws it.
    [mate.py, server.py, vision.py]
2026-11-02 Flip cards with Mate; refuse moves after an unnoticed GRBL reset
    Mate flips cards over: the crane places a card on the lowered flipper,
    Mate lifts and rolls forward together, and the card tips over. Recipe,
    speeds (80% of max) and the new hand's geometry are in the agent guides,
    the 3D view and the READMEs.
    After a GRBL reset the hub used to skip its limit checks; now moves,
    jogs, tip and Mate goto refuse until re-anchored. GRBL found in alarm on
    connecting counts as a reset (a Pi boot resets the Uno before the hub
    listens), and the flag survives hub restarts.
    [grbl.py, mate.py, server.py, vision.py]
2026-11-02 Give Mate gestures, a natural voice and a live chat on one port
    - Mate talks with 29 gestures (agent/gestures.json, POST /api/mate/gesture):
    a reaction face (24 new ones), flipper and wheel moves that end where they
    started, logged in the chat as Mate's. Mate never speaks.
    - The agent speaks as itself: /api/say takes `by`; "the House" is gone.
    - Piper voice (Norman, pace 0.85) streamed per sentence; /api/voice picks it.
    - The talk page is a chat shared by players, agents and Mate, with live
    transcription through Muse Voice's realtime endpoint; agents long-poll
    GET /api/chat.
    - HTTP and HTTPS both on :8000.
    - Mate's wheels at full speed; the flipper at most ~60% of its max.
    Co-Author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
    [mate.py, serve.py, server.py, talk.py, voice.py]
2026-11-02 Give the table eyes: see, find and check with SAM 3.1 and Muse Spark
    - /api/see names what's on the board (Muse Spark); /api/find outlines each
    named thing in one chosen camera (SAM 3.1) and returns its footprint and
    pick point in board mm; /api/find/check says whether a pick took.
    - Find checks SAM's matches with Muse Spark and ignores the robot, using
    boxes around the cup, Z extrusion and Mate from where they're tracked.
    - Every see, find and check is kept on disk and listed on the new /vision
    page; the 3D scene scans with SAM and can render what it found low-poly.
    - Zero Z button (G10) for a Z that skipped steps; calibration no longer asks
    for the cup's height; jog map drawn as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
    [eyes.py, server.py, vision.py]
2026-11-02 Keep calibration on the board; re-anchor from both cameras
    - Calibration centres its grid on the board (rising to the travel height
    first), refuses before any move if a stop would take the cup past the
    bounds or Mate is under it, and moves at 3000 mm/min instead of rapids.
    A "Stop calibrating" button ends it after the current move.
    - The camera re-anchor triangulates the head marker from both cameras and
    keeps GRBL's Z, instead of reading one camera at the saved height; the 3D
    page offers it when the cameras disagree with the saved position.
    - Tests for the triangulation and every calibration refusal.
2026-11-02 Send Mate to look, check its way first, and measure heights from the side
    - /api/mate/look drives Mate to face a spot with its own camera; find and see
    with cam=mate then answer questions about it (a 4-chip stack counted right)
    - Every Mate move checks its way in a fresh cam 1 picture first (check, on by
    default; ~1 s, no API call) and refuses with in_the_way
    - New gestures on_it, counting and woke_up (a new x x face) and the routines in
    Mate's guide: say what Mate is doing, cover for a brownout in character
    - find?height=true: heights from cam 0 by two closed-form solves, with tests;
    off by default until cam 0 lines up at board level
    - Cup offset re-measured over chips (-2.4, -19.7)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
    [eyes.py, server.py, vision.py]
2026-11-02 Check Mate's way with its real footprint; draw round things as discs
    - The way check sweeps Mate's footprint (flipper included, 3 mm to spare)
    through the turns it really makes and the drive, and leaves all of Mate out
    of the picture (its arm and wheels were showing up as obstacles)
    - One flag, check (default on); check=false just goes, to push on purpose
    - find marks round footprints (round, w = diameter); the 3D scene draws them
    as discs, at height_mm when there is one
    - Park the head at the back right; guides updated
    [eyes.py, server.py]
2026-11-02 Calibrate faster and clear of Mate's home
    - The 3D page calibrates ±90 mm, 3 x 3 stops at 3 heights (27, was 48),
    clear of Mate at its new home; sideways moves at 6000 mm/min: 1:10, was ~3 min,
    same fit (cam 1 1.0-1.2 px, head check 2.5 mm)
    - Each camera's board-marker reference is the median over the stops, not the
    last one (the head hid cam 0's only board marker there: a false "moved")
2026-11-02 Note why the cup height stays 57 mm (a ruler says 77)
2026-11-02 Card pick: back to a 1 s pump; check Z first when cards stay behind
2026-11-02 Peek at hole cards with Mate; let Mate drive on its assumed position
    - Mate's guide: peeking at your own cards (card on the flipper ~130 mm ahead,
    flipper slowly to ~50°, read the corner index)
    - Mate's goto carries on from where it was last seen plus the moves since when
    the camera can't see it (glare, the gantry cable over its marker): `assumed`
    - Mate's home moved left to (-90, 215) to free the far side for cards
    Not yet run on the table: the assumed-position driving.
    [mate.py, server.py]
2026-11-02 Keep Mate's position when the camera can't see it; cards aren't in Mate's way
    - The hub keeps where Mate is: seen by cam 1, or where it was last seen plus
    the moves since (scene mate.assumed), saved across restarts (mate_pose.json)
    - Mate's way check ignores a single lying card (Mate drives over cards)
    - Guides: carrying a card near Mate (the card reaches past the cup), the
    assumed position, the card rule; log for today's hand
2026-11-03 Free vision for cards, chips and decks; one-press calibration from zero
    Vision
    - find places known things (cards, decks, poker chips) for their height from cam 1
    alone: the solid of known size whose outline matches (cylinder or box fit, which
    also steps diagonally so it doesn't stall where place and height trade off)
    - the scene names face-up cards from a cache on the Pi (cards.py): each card is
    flattened straight-on and matched; a new one is read by Muse once, on its own
    - the scene finds chip stacks (count, unrounded count, colour) and decks for free
    (chips.py), past the board edge so edge stacks aren't clipped; a hidden board
    marker is filled in from the other three
    - chip count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
    [cards.py, chips.py, eyes.py, server.py, vision.py]
2026-11-03 Find face-down cards by their backs; count chips by colour; cup heights per stack
    Cards
    - face-down cards are found by their blue back panels, so touching cards are each
    found; face up or down is matched against a learned back; glare is kept out;
    a card missed for one frame is held for a second
    - touching face-up cards are split where they narrow
    Chips
    - the scene counts by colour (white 3.20 n - 1.83, red 3.45 n - 1.83) and SAM's find
    has its own rule; every stack gives count_raw, sure, pick_z and place_z (planned
    for the taller stack when the count is borderline)
    Pages and guides
    - Scan with SAM: "For card games" skips asking what's there
    - poker guide: look fastest first, and ke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
    [cards.py, chips.py, eyes.py, server.py, vision.py]
2026-11-03 Peek at hole cards with Mate (tested); read unknown cards from the 3D page
    The peek: card dropped from Z 6 on the flipper, flipper to ~77° while Mate
    creeps 28 mm, two reads, flipper to ~90° drops the card, then down while
    backing 60 mm. Holding a card above Mate's camera proved unreliable. The
    crane crosses at Z 110 and goes straight down. The 3D page gets a Read
    cards button for unnamed face-up cards; Render poly shows only for things
    that aren't known pieces.
2026-11-03 Flip with the peek's moves; Mate's home and park spot; check odd cards with SAM
    The flip is the peek driving on 67 mm instead of reading (5♦ face up,
    turned 2°, 27 s). Keep ~30 mm in front of Mate clear for the arm; park
    the head at (120, 230) so neither Mate's marker nor a board marker is
    hidden; after a flip, Mate home and the card to its spot. When the free
    scene's cards look strange, check with SAM.
2026-11-03 Fix the MCP server's six problems: no homing, unlock, card depth, flip and peek, chat, runner
    - No homing tool: $H on a build without limit switches would drive the
    axes into the frame. unlock sends exactly $X instead, which an agent needs
    after any reset and had no way to send.
    - The hub allows Z down to -2 (card picks at -1.5, stubborn ones at -2), and
    the table guide's recipes use /api/move {z, feed} instead of raw G-code.
    - POST /api/mate/move runs one recipe step (flipper and wheels together,
    servo speed required and capped), counted into Mate's assumed place;
    MCP tool mate_move, used by the flip and the peek.
    - chat_post posts under the agent's name and refuses "player".
    - Th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
    [mate.py, server.py]
2026-11-04 Rename Mate to Esper; live agent runner; grip and lift rules; salvaged-frame wording
    Esper (was Mate): code, endpoints (/api/esper/*), guides, firmware
    (esper.local), hardware docs. The hub moves old data over (pose file, chat
    lines, vision photos).
    Agent runner: --live stays at the table and acts on what players say,
    --clear-chat, a batch tool (a whole recipe in one call), Esper greets and
    reacts by name, no y/N prompt, reasoning items aren't sent back (Meta's
    API expires them), a failed task doesn't end the session, ask='null'
    ignored, spoken lines kept short.
    Guides: never stop between a grip and its drop; lifting a card doesn't
    show it. Hub: Clear archives the chat to chats/ and ids ke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
    [corner-normal-v3.stl, corner-thick-v3.stl, fit-test.stl, slot-test.stl, wheel-70.stl]
2026-11-04 Rewrite the README for submission; add an MIT license
    The README now leads with the idea (two limited robots and Muse Spark,
    more than the sum of their parts), what works and what's tested, the Meta
    models used and for what, how it fits together, the salvaged-frame note,
    how to run it, and the current layout. MIT license. The agent README
    describes the MCP server and runner that exist; the plan's status is
    current; the ghost is marked as planned, not built.
2026-11-05 Add Esper faces and the esper_face tool; crane margins and move fixes
    Esper: thinking and focused faces while slow calls run, new faces and
    gestures, wheel limits of speed 500 and accel 400.
    Crane: bounds margins, and slow moves keep their feed on the last leg.
    Jog page: the reset banner has a single Unlock button.
    [esper.py, server.py, vision.py]
2026-11-05 Add peek, stack, reveal and frame photos to the README
